marian1911/CUBESAT_Transponder/README.md

Todos los archivos de diseño, simulaciones, componentes y codigo referido a transponder cubesat VHF-UHF
