marian1911/CUBESAT_Transponder/Simulaciones/filter_esquema.pdf

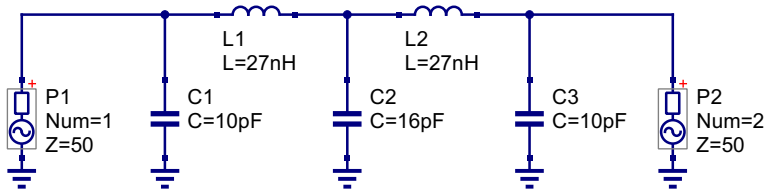
[picture p121: figure]
P1 Num=1 Z=50; P2 Num=2 Z=50

### s-parameter simulation

SP1
Type=log
Start=1MHz Stop=1GHz Points=1000 low-pass filter, 450MHz cutoff 5

th order Chebyshev , PI-type, impedance 50 Ω
