marian1911/CUBESAT_Transponder/Simulaciones/cascode_1.pdf

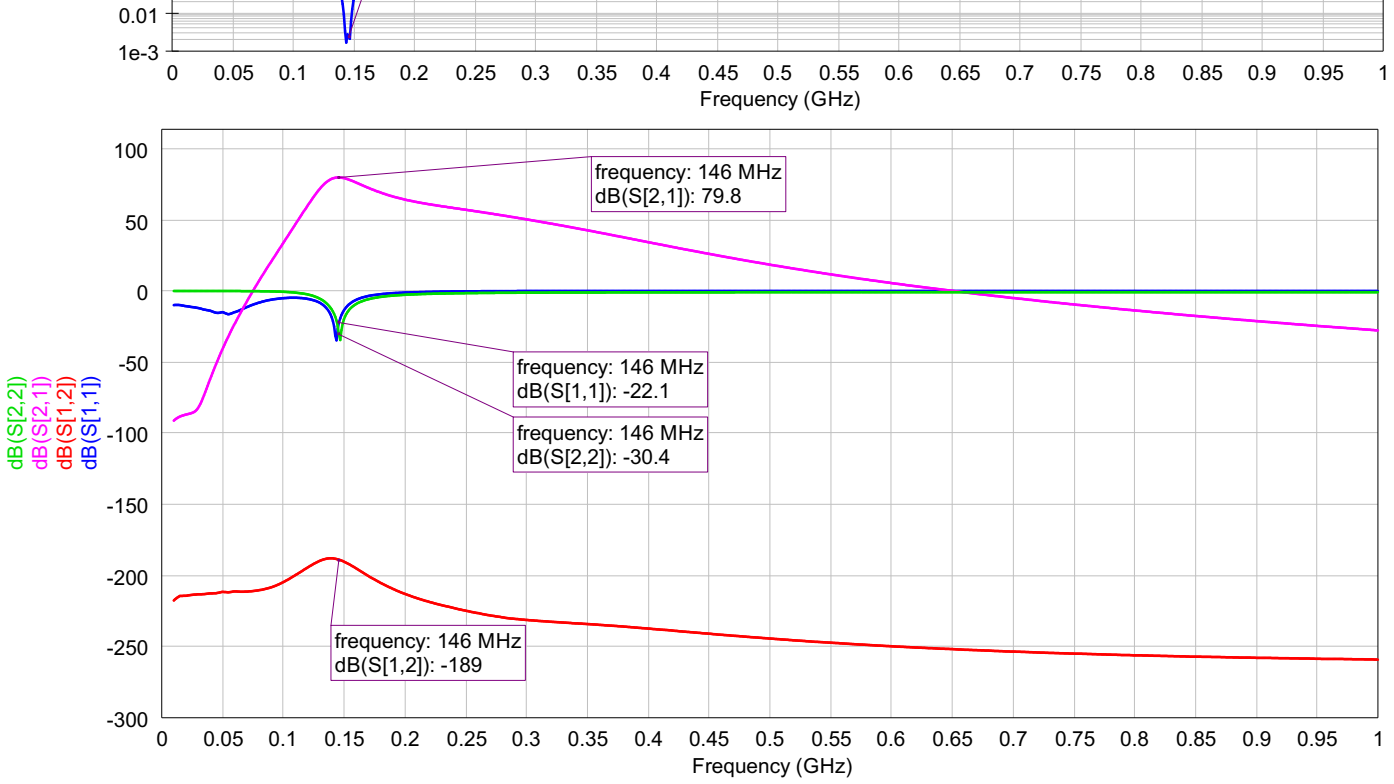
[picture p122: figure]
Frequency (GHz); frequency: 146 MHz dB(S[1,2]): -189; frequency: 146 MHz dB(S[2,1]): 79.8

equation Coeficiente de Rollet

Determinante delta

Eqn1
k=(1 - mag(S[1,1])^2 - mag(S[2,2])^2 + mag(S[1,1]*S[2,2] - S[1,2]*S[2,1])^2) / (2 * mag(S[1,2] * S[2,1])) delta=mag(S[1,1]*S[2,2] - S[1,2]*S[2,1])

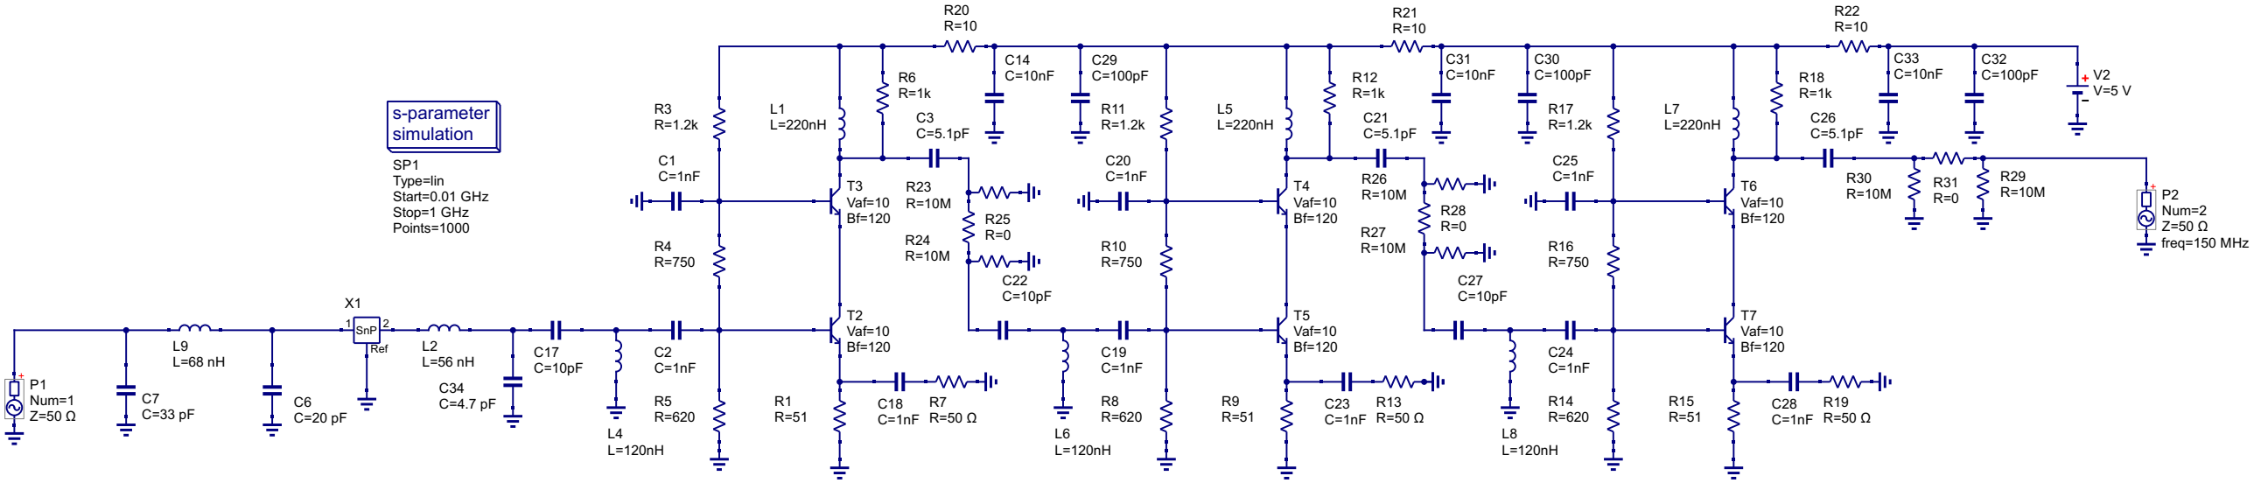
[picture p123: figure]
P2 Num=2 Z=50 Ω; freq=150 MHz R31 R=0; T2 Vaf=10 Bf=120; T3 Vaf=10 Bf=120; T4 Vaf=10 Bf=120; T5 Vaf=10 Bf=120; T6 Vaf=10 Bf=120; T7 Vaf=10 Bf=120; SnP; Ref; P1 Num=1 Z=50 Ω; s-parameter simulation

Type=lin Start=0.01 GHz Stop=1 GHz Points=1000 frequency: 146 MHz dB(S[1,1]): -22.1 frequency: 146 MHz dB(S[1,1]): -22.1

frequency: 146 MHz dB(S[2,2]): -30.4 frequency: 146 MHz dB(S[2,2]): -30.4

0 | 0.1 | 0.2 | 0.3 | 0.4 | 0.5 | 0.6 | 0.7 | 0.8 | 0.9 | 1

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
# dB(S[1,1]) dB(S[2,2])

Frequency (GHz)

0 | 0.2 | 0.4 | 0.6 | 0.8 | 1

-100

-50

0

50

100

dB(S[2,1])

Frequency (GHz)

0 | 0.2 | 0.4 | 0.6 | 0.8 | 1

-260

-250

-240

-230

-220

-210

-200

-190

-180

dB(S[1,2])

Frequency (GHz)

frequency

S[1,1] S[2,2]

frequency: 146 MHz S[1,1]: 0.0781 / -33.6° Z = 56.9 / -4.97°

frequency: 146 MHz S[1,1]: 0.0781 / -33.6° Z = 56.9 / -4.97° frequency: 146 MHz S[2,2]: 0.0301 / -139° Z = 47.8 / -2.27°

frequency: 146 MHz S[2,2]: 0.0301 / -139° Z = 47.8 / -2.27°

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
1e10

1e11

delta

k

frequency: 146 MHz delta: 0.00235

frequency: 146 MHz delta: 0.00235

frequency: 146 MHz
k: 1.41e+05

frequency: 146 MHz

k: 1.41e+05 ========================================= CALCULO DE ADAPTACION DE ENTRADA (146 MHz) ========================================= Objetivo: Adaptar fuente de 50 ohms a la entrada del primer cascode. 1. Parametros Iniciales: - Impedancia medida (S11): 196 / -43.9 grados

- Equivalente rectangular: Zin = 141.2 - j135.9 ohms
- Equivalente paralelo: R_paralelo = 272 ohms, X_paralelo = -283 ohms (Capacitancia parásita)
2. Diseño de Red Tipo L: - Factor de Calidad (Q) = raiz(272 / 50 - 1) = 2.1
3. Componentes Finales: - Inductor Paralelo (Base a Masa): Debe cancelar la reactancia parásita y adaptar. Valor L = 96.5 nH
- Capacitor Serie (Fuente a Base): Bloquea DC y completa adaptación. Xc = 105 ohms. Valor C = 10.4 pF

========================================= CALCULO DE ADAPTACION DE SALIDA (146 MHz) ========================================= Objetivo: Adaptar la salida de alta impedancia a 50 ohms. 1. Parametros Iniciales: - Impedancia interna del transistor: 1570 / -89.9 grados

- Equivalente paralelo: Rp = 900 kOhms, Cp = 0.69 pF
- Resistencia de carga (Load Line) impuesta por diseño: 1000 ohms
2. Diseño de Red Tipo L (Absorbiendo parásitos): - Factor de Calidad (Q) = raiz(1000 / 50 - 1) = 4.36
3. Componentes Finales: - Capacitor Serie (Colector a Carga): Xc = 50 * 4.36 = 218 ohms. Valor C16 = 5.0 pF
- Inductor Paralelo (Colector a VCC): Reactancia ideal = 1000 / 4.36 = 229.4 ohms. Compensando los 0.69 pF internos, la reactancia baja a 200.1 ohms. Valor L3 = 218 nH

=========================================

Atenuador de 3 dB
Resistencias a masa (Shunt): 300 ohmios
Resistencia en serie (Series): 18 ohmios

Atenuador de 6 dB
Resistencias a masa (Shunt): 150 ohmios Resistencia en serie (Series): 39 ohmios

Atenuador de 12 dB
Resistencias a masa (Shunt): 82 ohmios Resistencia en serie (Series): 91 ohmios
