marian1911/CUBESAT_Transponder/Librerias/Infineon/BGB741L7ESDE6327XTSA1/Infineon_LNA_Switch/Readme.txt

*******************************************************************
*
*     INFINEON ADS LIBRARY for MMIC LNA
*
*     Version 3.0
*     Date 01/02/2018
*
*     Copyright (C) 2015 by Infineon Technologies AG, Neubiberg, Germany
*     all rights reserved
*
*
*     This library contains the following MMIC LNAs:
*
*     BGA622L7		BGA7L1N6		BGA7M1N6
*     BGA7H1N6		BGA7L1BN6		BGA7H1BN6
*     BGA6L1BN6		BGA6H1BN6		BGA8L1BN6		      
*     BGA8H1BN6  	BGA8V1BN6		BGA8U1BN6
*     BGA824N6		BGA622L7		BGA777N7   
*     BGA711N7		BGA713N7		BGA751N7     
*     BGA735N16		BGA748L16     		BGA15LA12
*     BGA15MA12     	BGM16HA12		BGM12LAB9
*     BGM13GAB9		BGM13HAB9		BGM15LAB12     
*     BGM17LAB12	BGM7LLHM4L12		BGM7LMHM4L12  
*     BGM7MLLM4L12	BGM7MHLL4L12		BGA728L7
*     BGA729N6		BGB741L7ESD		BGB707L7ESD  
*     BGB719N7ESD  	BGA524N6		BGA924N6
*     BGA231N7		BGA428			BGA615L7                   
*     BGA925L6		BGA725L6                  
*                       
*                       
*
*
*******************************************************************

Please note that the Infineon Component Library has the same folder names, independent on the library version.
Therefore your current Infineon libraries may be overwritten when installing a newer one. Please rename your
current ADS library folder for your own records or contact the Infineon Customer Support
for older versions of your library. If using the new library with an older design make
sure to add the new library to your workspace.
