marian1911/CUBESAT_Transponder/Para análisis/Links.txt

https://haciaelespacio.aem.gob.mx/revistadigital/articul.php?interior=1128

https://alen.space/es/guia-basica-de-nanosatelites/
