marian1911/CUBESAT_Transponder/Invoice_jlcpcb.pdf

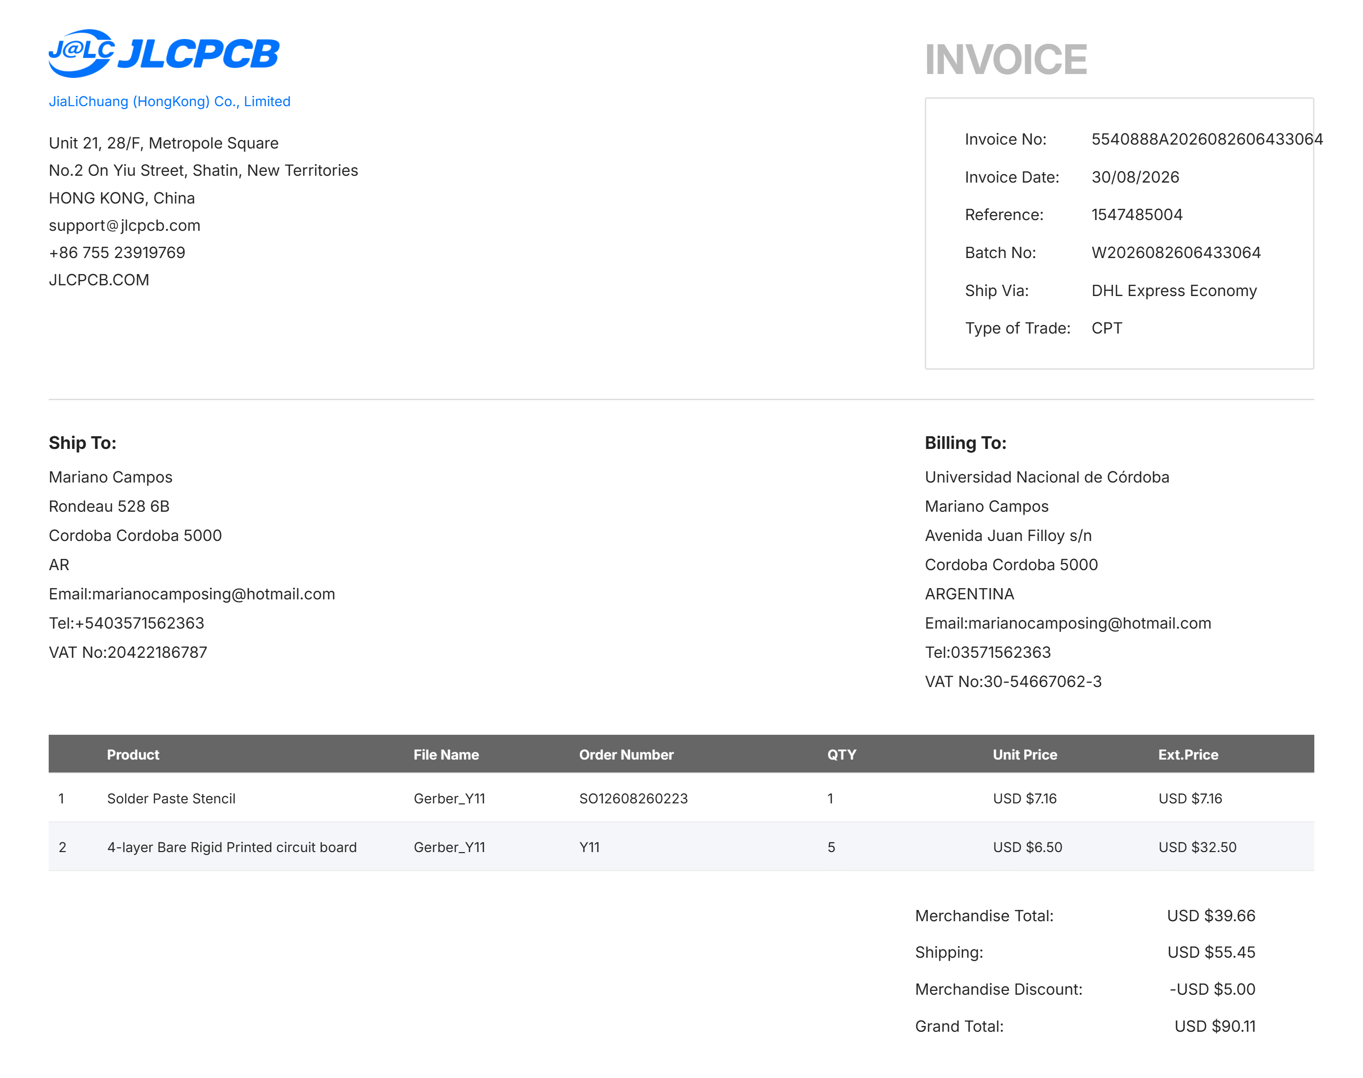
[picture p148: figure]
