marian1911/CUBESAT_Transponder/Factura_JLCPCB.pdf

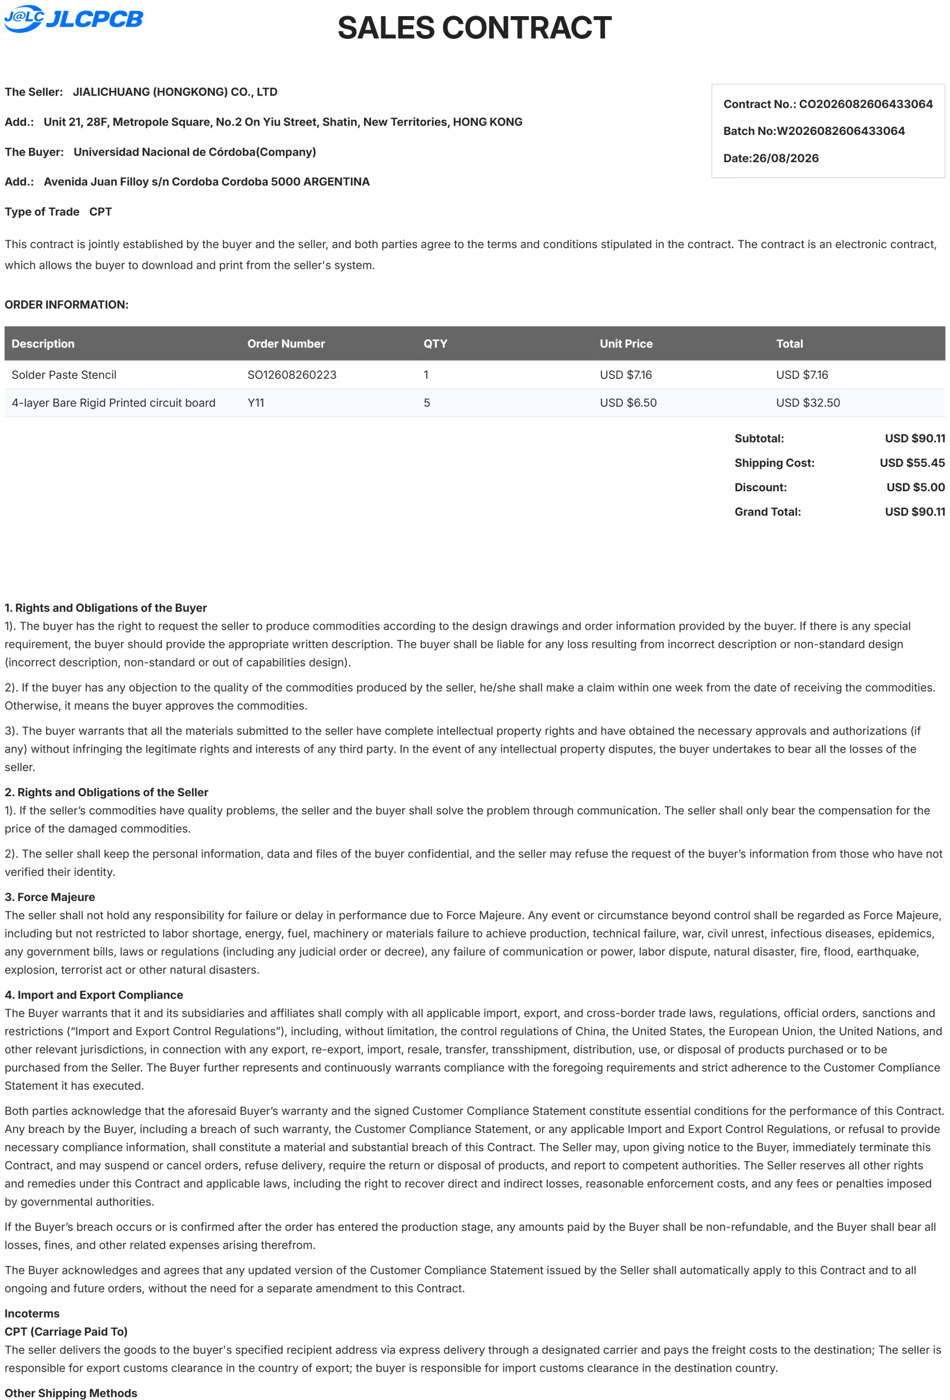
[picture p149: page 1]

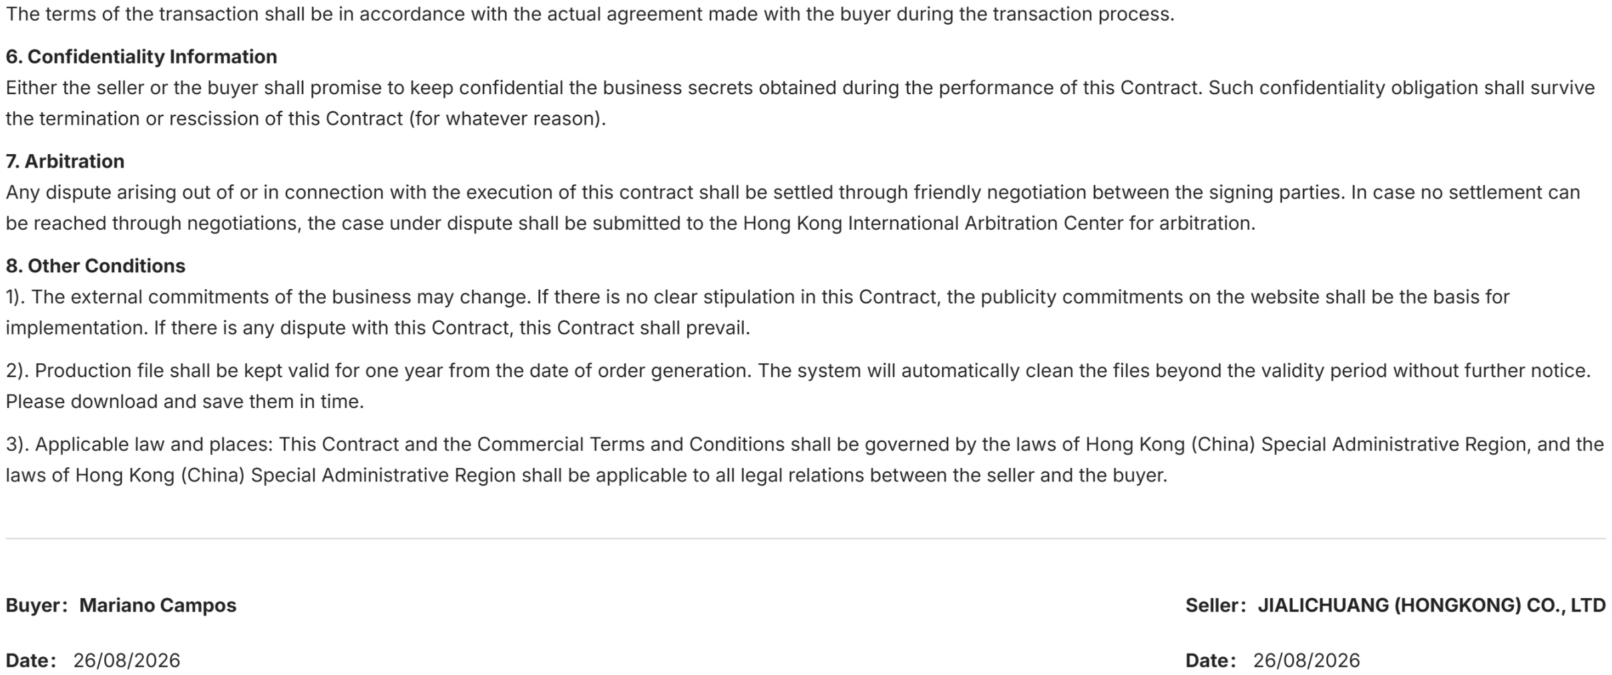
[picture p150: figure]
