marian1911/CUBESAT_Transponder/Simulaciones/lna.pdf

L1L=68 nH | SnPRef 1 | 2 X1 | L2L=56 nH | C5 C=4.7 pF C7 C=33 pF | C6 C=20 pF P1Num=1 Z=50 Ω | P2Num=2 Z=50 Ω s-parameter simulation SP1 Type=lin Start=0.01 GHz Stop=1 GHz Points=991 | 0 | 0.1 | 0.2 | 0.3 | 0.4 | 0.5 | 0.6 | 0.7 | 0.8 | 0.9 | 1 -100 -80 -60 -40 -2002040 dB⁽S[1,1]) dB⁽S[1,2]) dB⁽S[2,1]) dB⁽S[2,2]) | Frequency (GHz) frequency: 146 MHz dB(S[1,1]): -28 frequency: 146 MHz dB(S[1,1]): -28frequency: 146 MHz dB(S[1,2]): -28.1 frequency: 146 MHz dB(S[1,2]): -28.1 frequency: 146 MHz dB(S[2,1]): 23.9 frequency: 146 MHz dB(S[2,1]): 23.9 frequency: 146 MHz dB(S[2,2]): -32.1 frequency: 146 MHz dB(S[2,2]): -32.1 | 0 | 0.1 | 0.2 | 0.3 | 0.4 | 0.5 | 0.6 | 0.7 | 0.8 | 0.9 | 1 050 100 150 200 250 300 350 stoz⁽S[1,1]) stoz⁽S[2,2]) | Frequency (GHz) frequency: 146 MHz stoz(S[1,1]): 53.8 / -1.74° frequency: 146 MHz stoz(S[1,1]): 53.8 / -1.74° frequency: 146 MHz stoz(S[2,2]): 49.5 / 2.81° frequency: 146 MHz stoz(S[2,2]): 49.5 / 2.81°
