marian1911/CUBESAT_Transponder/PI/Informe/imagenes/cascode_3.png

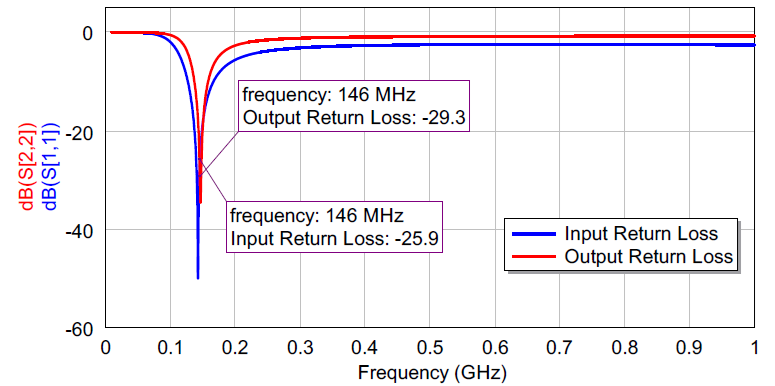
PI/Informe/imagenes/cascode_3.png
