marian1911/CUBESAT_Transponder/PI/Informe/imagenes/sat1.jpeg

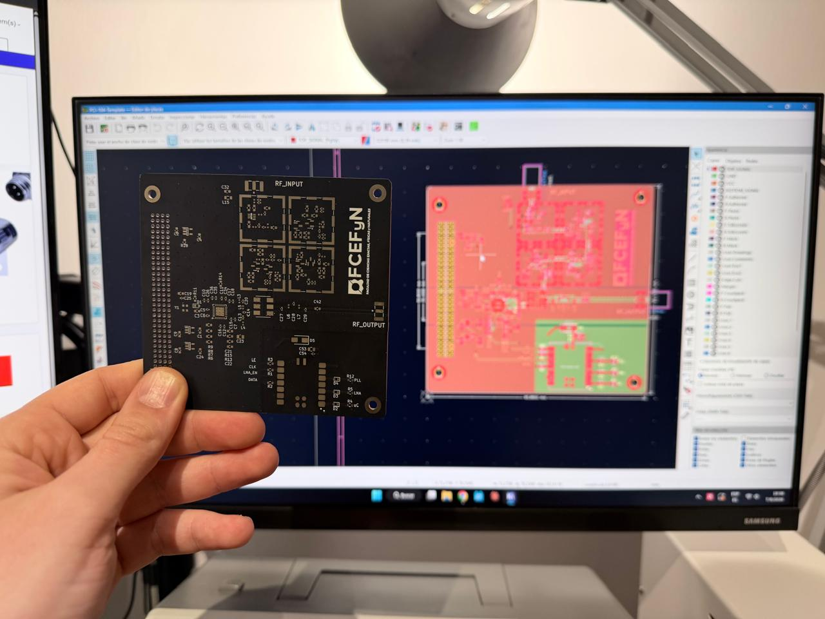
PI/Informe/imagenes/sat1.jpeg
