marian1911/CUBESAT_Transponder/PI/Informe/imagenes/sat2.jpeg

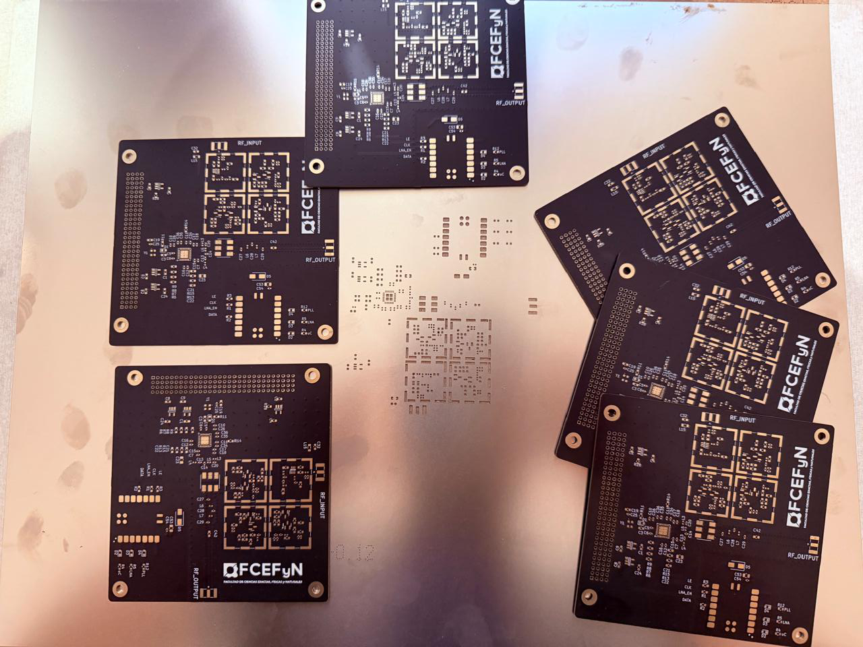
PI/Informe/imagenes/sat2.jpeg
