marian1911/CUBESAT_Transponder/PI/Informe/imagenes/sat3.jpeg

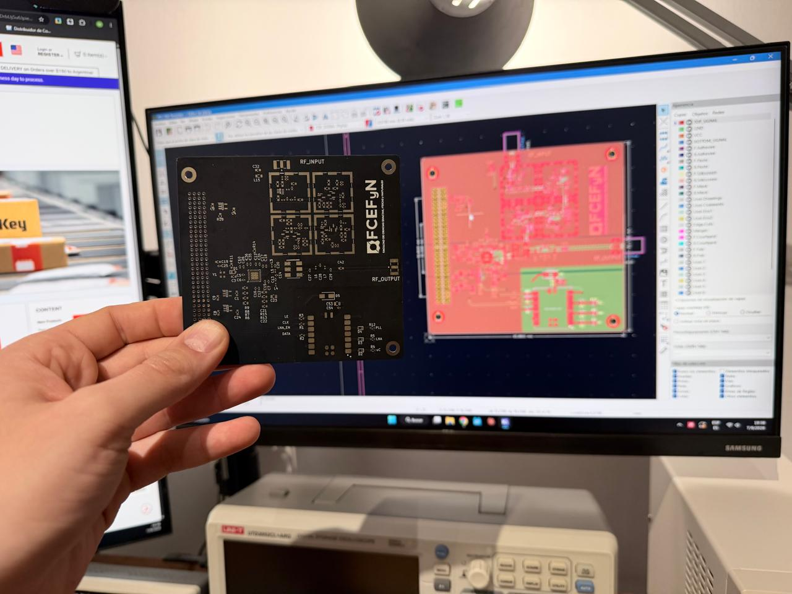
PI/Informe/imagenes/sat3.jpeg
