marian1911/CUBESAT_Transponder/PI/Informe/imagenes/stencil.jpeg

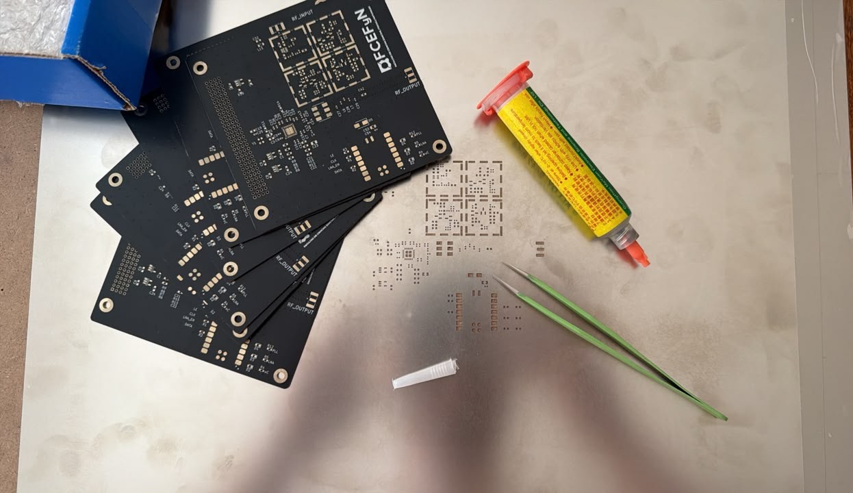
PI/Informe/imagenes/stencil.jpeg
