marian1911/CUBESAT_Transponder/PI/Presentacion/Imagenes/contenteetimes-images-00-max-embedded-2017-01-jan-rob-0001-emb-cst-01.webp

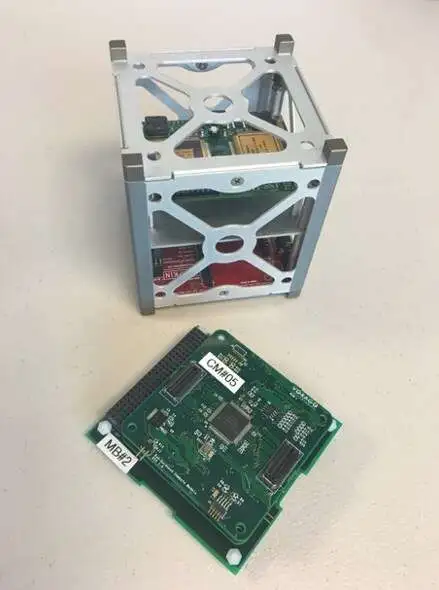
PI/Presentacion/Imagenes/contenteetimes-images-00-max-embedded-2017-01-jan-rob-0001-emb-cst-01.webp
