marian1911/CUBESAT_Transponder/PI/Presentacion/Imagenes/CubeSats_solar_panel_standard_DHV.webp

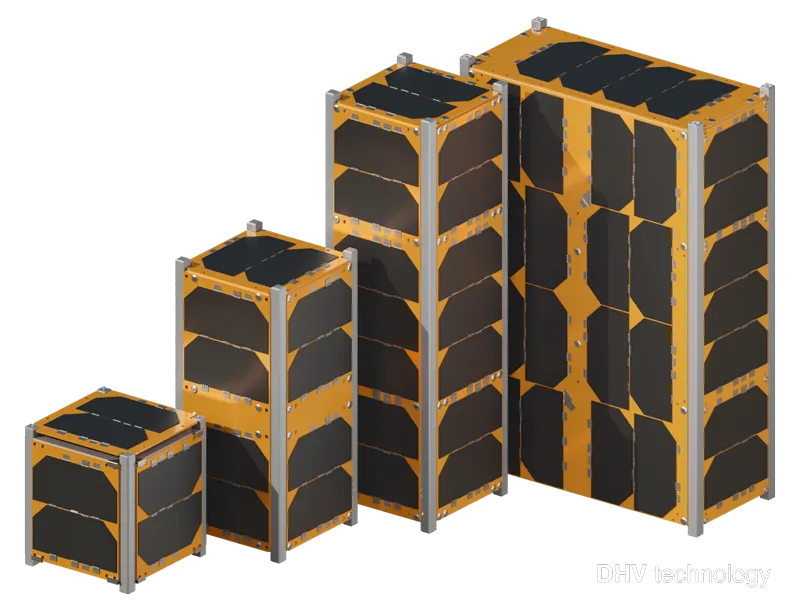
PI/Presentacion/Imagenes/CubeSats_solar_panel_standard_DHV.webp
