marian1911/CUBESAT_Transponder/PI/Presentacion/Imagenes/images (1).jpg

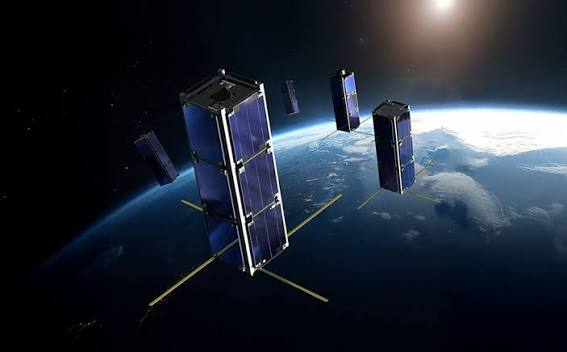
PI/Presentacion/Imagenes/images (1).jpg
