marian1911/CUBESAT_Transponder/PI/Presentacion/Imagenes/images.jpg

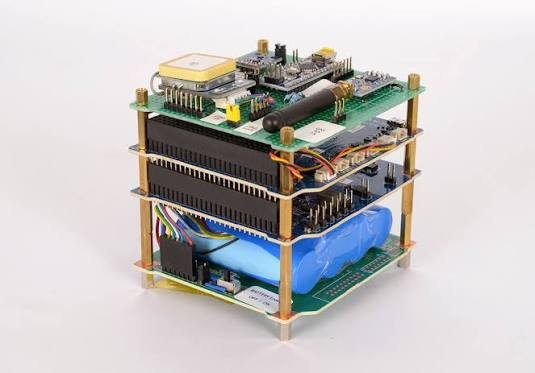
PI/Presentacion/Imagenes/images.jpg
