marian1911/CUBESAT_Transponder/PI/Presentacion/Imagenes/ITUpSat1_Auto2.jpg

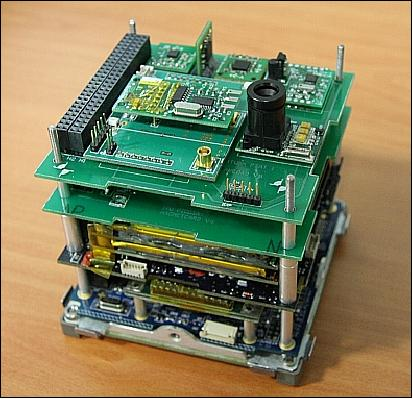
PI/Presentacion/Imagenes/ITUpSat1_Auto2.jpg
