marian1911/CUBESAT_Transponder/PI/Presentacion/Imagenes/payload.png

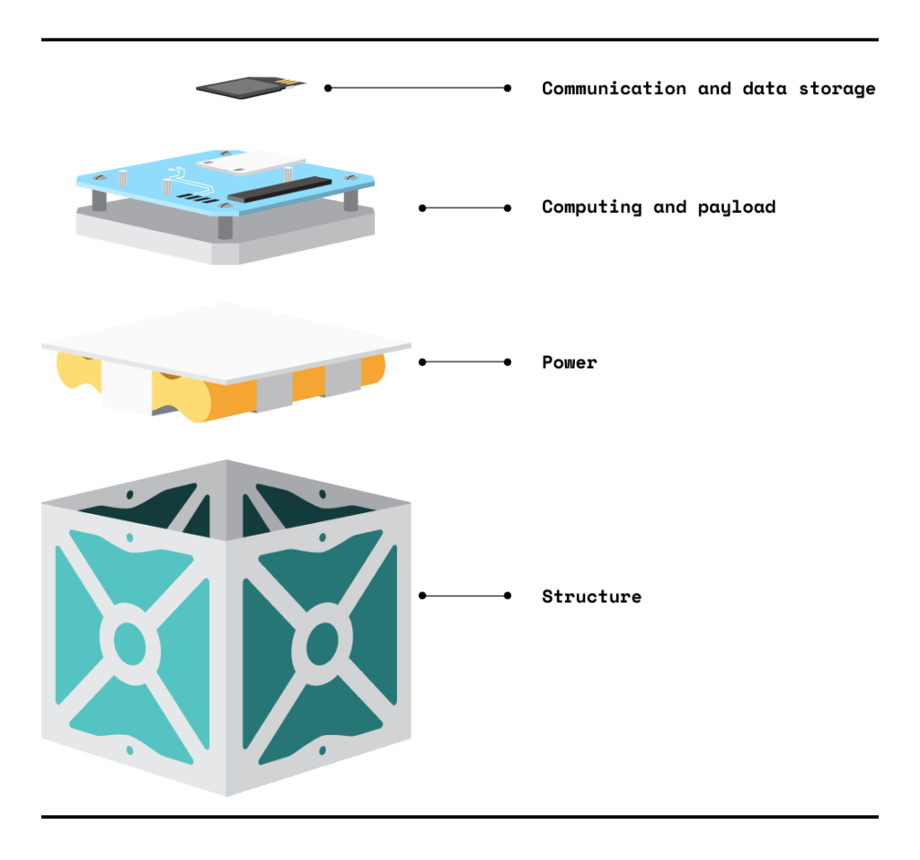
PI/Presentacion/Imagenes/payload.png
