marian1911/CUBESAT_Transponder/PI/Presentacion/Imagenes/satsearch_0qvm50_innovative_solutions_in_space_vhf_uplink_uhf_downlink.png

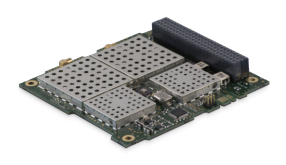
PI/Presentacion/Imagenes/satsearch_0qvm50_innovative_solutions_in_space_vhf_uplink_uhf_downlink.png
