marian1911/CUBESAT_Transponder/PI/Presentacion/Imagenes/satsearch_product-image_mcdilp_data_patterns_cubesat_vhf_uhf_transceiver.png

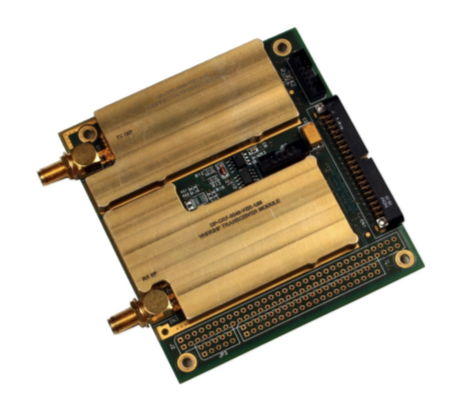
PI/Presentacion/Imagenes/satsearch_product-image_mcdilp_data_patterns_cubesat_vhf_uhf_transceiver.png
