marian1911/CUBESAT_Transponder/KICAD_CUBSAT_V1/BOM.csv

Qty | Manufacturer_Part_Number | Mouser Part Number
1 | ADP150AUJZ-3.3-R7 | 584-ADP150AUJZ3.3R7
3 | TNPW02011K20BEED | 71-TNPW02011K20BEED
3 | CRCW0201620RFKED | 71-CRCW0201620RFKED
3 | CRCW01000000Z0EL | 71-CRCW01000000Z0EL
1 | 102010328 | 713-102010328
2 | GJM1555C1H5R6WB01D | 81-GJM1555C1H5R6WB1D
2 | GCM1885C1H181JA16D | 81-GCM1885C1H181J16D
1 | GRM1555C1H121JA01D | 81-GRM1555C1H121JA01
1 | GCM1885C1H112JA16D | 81-GCM1885C1H112JA6D
1 | GCM21B5C2A333GE02L | 81-GCM21B5C2A333GE2L
1 | MCT0603MD7501BP500 | 594-MCT0603MD7501BP5
1 | RC0603FR-07464RL | 603-RC0603FR-07464RL
1 | RC0603FR-072K94L | 603-RC0603FR-072K94L
1 | LQW15AN68NG0ZD | 81-LQW15AN68NG0ZD
1 | LQW15AWR18J80D | 81-LQW15AWR18J80D
10 | TNPW060349R9FEEA | 71-TNPW060349R9FEEA
2 | SMA-J-P-H-ST-EM1 | 200-SMAJPHSTEM1
1 | ADE-5+ | 139-ADE-5
1 | LQW15AN56NG8ZD | 81-LQW15AN56NG8ZD
3 | LQW18ANR22G00D | 81-LQW18ANR22G00D
1 | PSA-5454+ | 139-PSA-5454
2 | LQW15AN30NG00D | 81-LQW15AN30NG00D
2 | LQW15AN27NG00D | 81-LQW15AN27NG00D
4 | LQW15AWR12G80D | 81-LQW15AWR12G80D
2 | CRCW040282R0FKTD | 71-CRCW040282R0FKTD
1 | CRCW040291R0FKED | 71-CRCW040291R0FKED
1 | CRCW040239R0FKED | 71-CRCW040239R0FKED
2 | CRCW0402150RFKED | 71-CRCW0402-150-E3
3 | MCT06030D7500BP500 | 594-MCT06030D7500BP5
2 | MCT06030C1009FP500 | 594-MCT06030C1009FP5
1 | ECS-TXO-2520MV-100-AY-TR | 520-TXO2520MV100AYTR
3 | GJM0225C1C5R1BB01L | 81-GJM0225C1C5R1BB1L
4 | BMI-S-102 | 739-BMI-S-102
4 |  | 859-LTST-C190GKT
1 | LQW21FT1R0M0HL | 81-LQW21FT1R0M0HL
1 | GRT21BR61E106KE13L | 81-GRT21BR61E106KE3L
1 | GJM0225C1E4R7BB01L | 81-GJM0225C1E4R7BB1L
1 | GCM1555C1H330FA16J | 81-GCM1555C1H330FA6J
1 | GJM1555C1H200FB01D | 81-GJM1555C1H200FB1D
4 | GRM188R61E225KA12D | 81-GRM188R61E225KA2D
3 | GCM1555C1H101FA16J | 81-GCM1555C1H101FA6J
3 | GRM188R61A105KA61D | 81-GRM39R105K10
1 | TNPW06035K10FHTA | 71-TNPW06035K10FHTA
1 | SS14 | 512-SS14
1 | ADF4351BCPZ-RL7 | 584-ADF4351BCPZ-R7
2 | ADP7118WAUJZ-5.0-R7 | 584-P7118WAUJZ-50-R
7 | TNPW06031K00FHEA | 71-TNPW06031K00FHEA
12 | GRM1885C1H102JA01D | 81-GRM39C102J50
1 | GRM1555C1H100JA01D | 81-GRM1555C1H100JA1D
5 | TNPW060310K0FEEA | 71-TNPW060310K0FEEA
11 | GRM155R71C104KA88D | 81-GRM155R71C104KA88
1 | GJM1555C1H160FB01J | 81-GJM1555C1H160FB1J
1 | GRM1885C1H152JA01J | 81-GRM185C1H152JA01J
11 | GJM1555C1H100FB01D | 81-GJM1555C1H100FB01
