marian1911/CUBESAT_Transponder/Librerias/Crystek/CVCO55BE-0400-0800/3D/CVCO55BE-0400-0800.stp

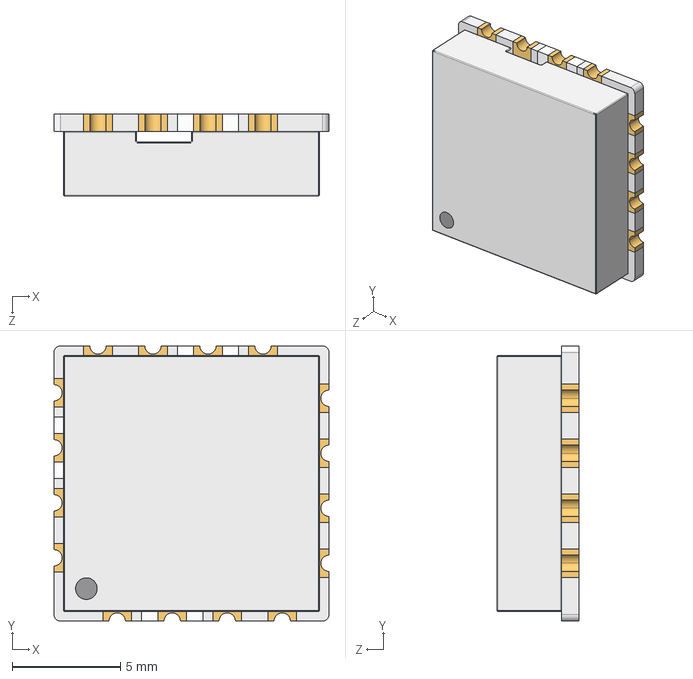
[picture p164: CAD file, 2026-08-06]
Librerias/Crystek/CVCO55BE-0400-0800/3D/CVCO55BE-0400-0800.stp
12.7 x 12.7 x 3.81 mm
