marian1911/CUBESAT_Transponder/Librerias/Laird/bmi-s-102-stp-file.STP

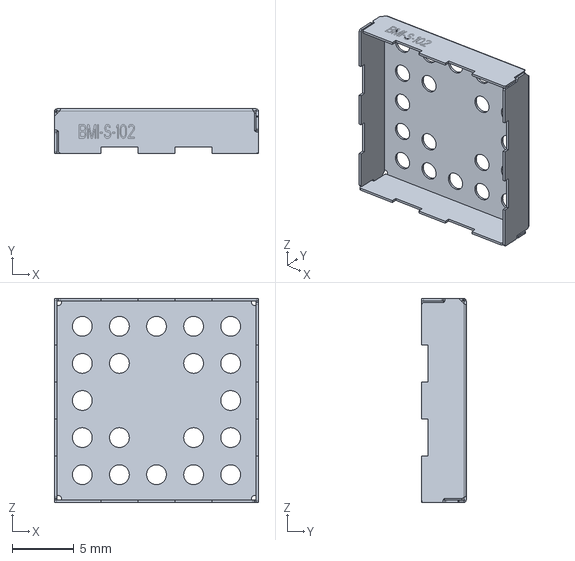
[picture p165: CAD file, 2026-08-06]
Librerias/Laird/bmi-s-102-stp-file.STP
16.5 x 3.60 x 16.5 mm
