marian1911/CUBESAT_Transponder/Librerias/EPCOS/LIB_B39431B3710U410/B39431B3710U410/3D/B39431B3710U410.stp

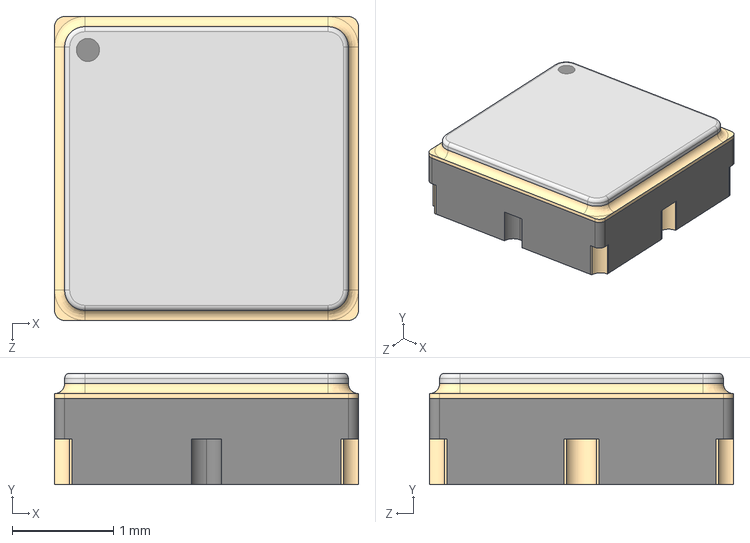
[picture p166: CAD file, 2026-08-06]
Librerias/EPCOS/LIB_B39431B3710U410/B39431B3710U410/3D/B39431B3710U410.stp
3.00 x 1.10 x 3.00 mm
