marian1911/CUBESAT_Transponder/(list of files, cad)

Other CAD files:
Librerias/Crystek/CVCO55BE-0400-0800/DEHDL/cvco55be_0400_0800/chips/chips.prt
Librerias/ECS/ECS-TXO-2520MV-120-AY-TR/DEHDL/ecs_txo_2520mv_120_ay_tr/chips/chips.prt
Librerias/EPCOS/LIB_B39431B3710U410/B39431B3710U410/DEHDL/b39431b3710u410/chips/chips.prt
Librerias/Infineon/BGB741L7ESDE6327XTSA1/BGB_741L7ESD_E6327/DEHDL/bgb_741l7esd_e6327/chips/chips.prt
Librerias/ST/STM32L422CBT6/DEHDL/stm32l422cbt6/chips/chips.prt
Librerias/Torex/XC6206P302MR-G/DEHDL/xc6206p302mr_g/chips/chips.prt
Librerias/analog-device/ADF4117/ADF4117BRUZ-RL7/DEHDL/adf4117bruz_rl7/chips/chips.prt
Librerias/analog-device/ADF4351BCPZ/ADF4350BCPZ-RL7/DEHDL/adf4350bcpz_rl7/chips/chips.prt
Librerias/analog-device/ADP150/ADP150AUJZ-2.65-R7/DEHDL/adp150aujz_2.65_r7/chips/chips.prt
Librerias/mini-circuit/ADE-5+/ADE-5+/DEHDL/ade_5_/chips/chips.prt
Librerias/mini-circuit/PGA-103/PGA-103+/DEHDL/pga_103_/chips/chips.prt
Librerias/mini-circuit/PSA2-6+/PSA2-6+/DEHDL/psa2_6_/chips/chips.prt
Librerias/mini-circuit/TCCH-80+/LIB_TCCH-80+/TCCH-80+/DEHDL/tcch_80_/chips/chips.prt
