marian1911/CUBESAT_Transponder/Simulaciones/pdn_z_graficos.pdf

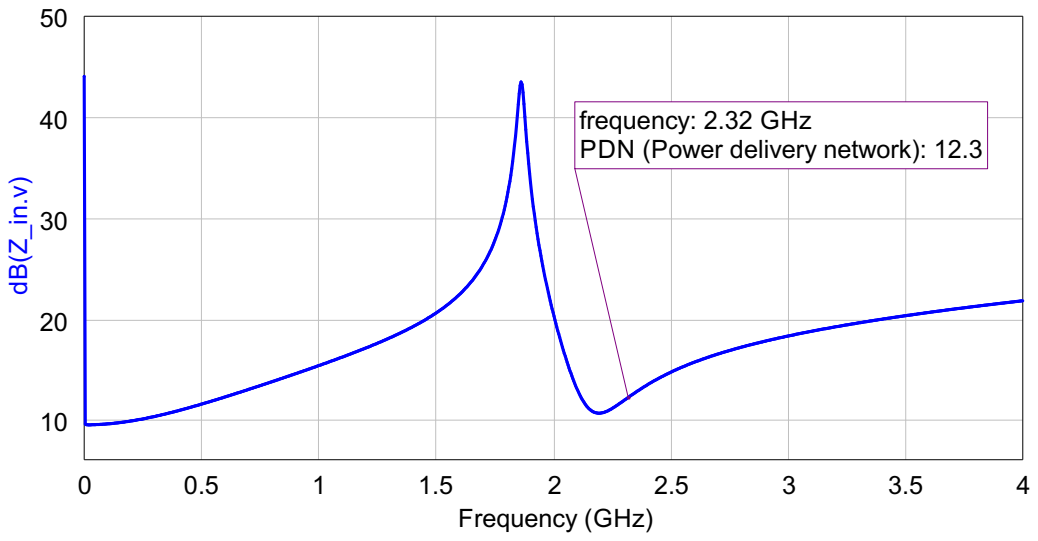
[picture p167: page 1]
Frequency (GHz)

frequency: 2.32 GHz PDN (Power delivery network): 12.3
