marian1911/CUBESAT_Transponder/Simulaciones/filter.pdf

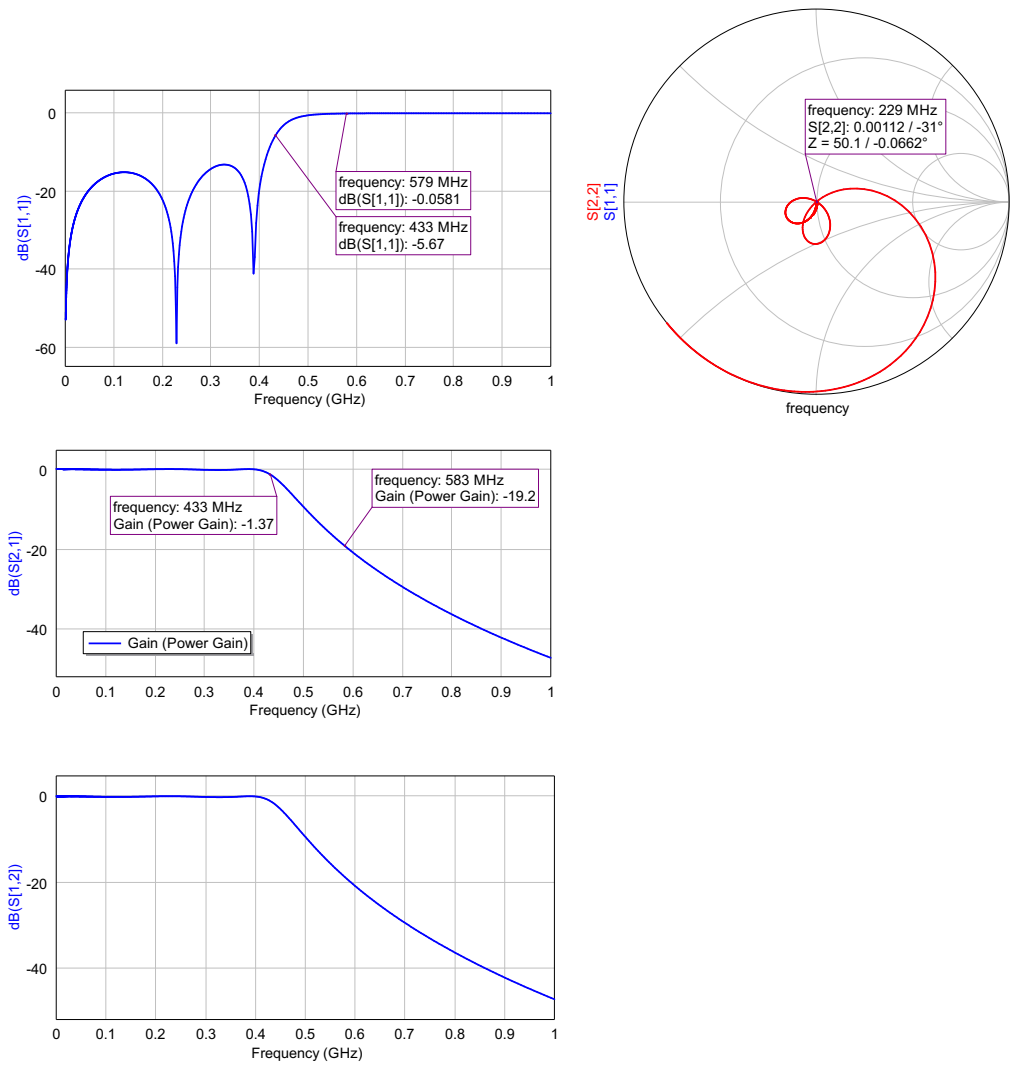
[picture p168: page 1]
frequency; frequency: 229 MHz S[2,2]: 0.00112 / -31° Z = 50.1 / -0.0662°; Frequency (GHz)

frequency: 579 MHz dB(S[1,1]): -0.0581

frequency: 433 MHz dB(S[1,1]): -5.67

frequency: 583 MHz Gain (Power Gain): -19.2

frequency: 433 MHz Gain (Power Gain): -1.37

Gain (PGoawiner(PGoawine)r Gain)
