marian1911/CUBESAT_Transponder/Simulaciones/car_lna.pdf

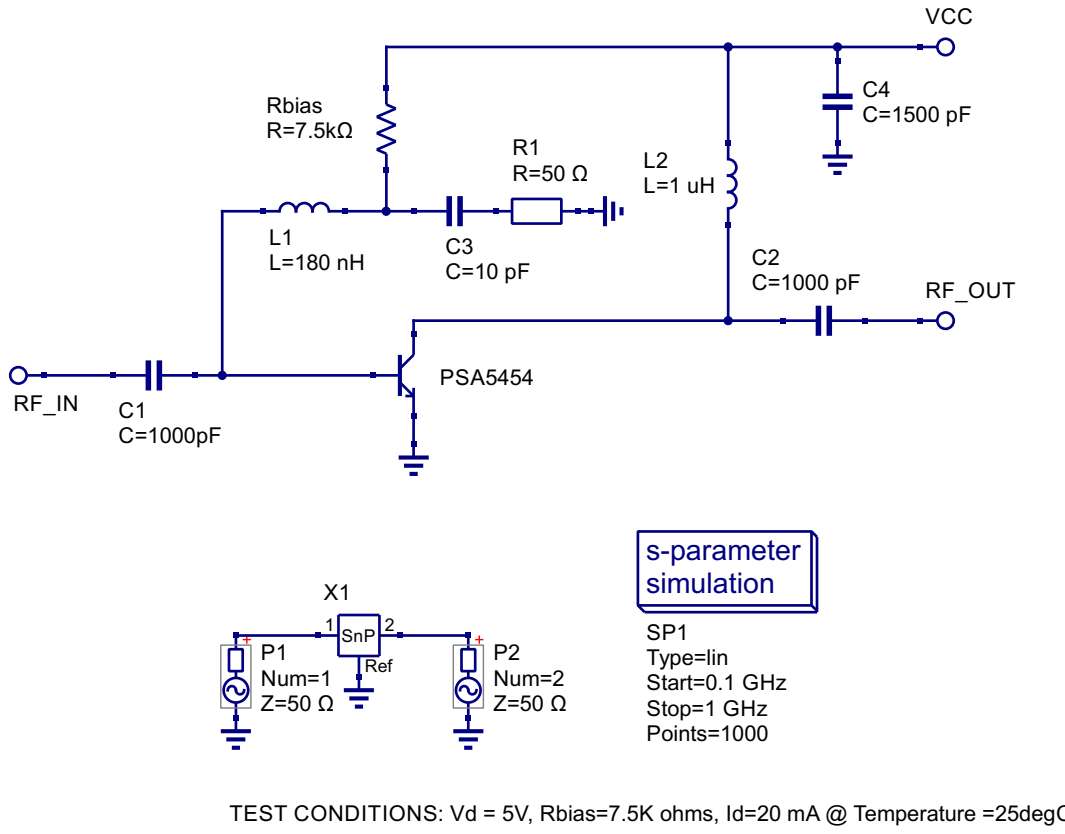
[picture p169: page 1]

Type=lin Start=0.1 GHz Stop=1 GHz Points=1000

TEST CONDITIONS: Vd = 5V, Rbias=7.5K ohms, Id=20 mA @ Temperature =25degC
