marian1911/CUBESAT_Transponder/KICAD_CUBSAT_V1/PCI-104-Template.pdf

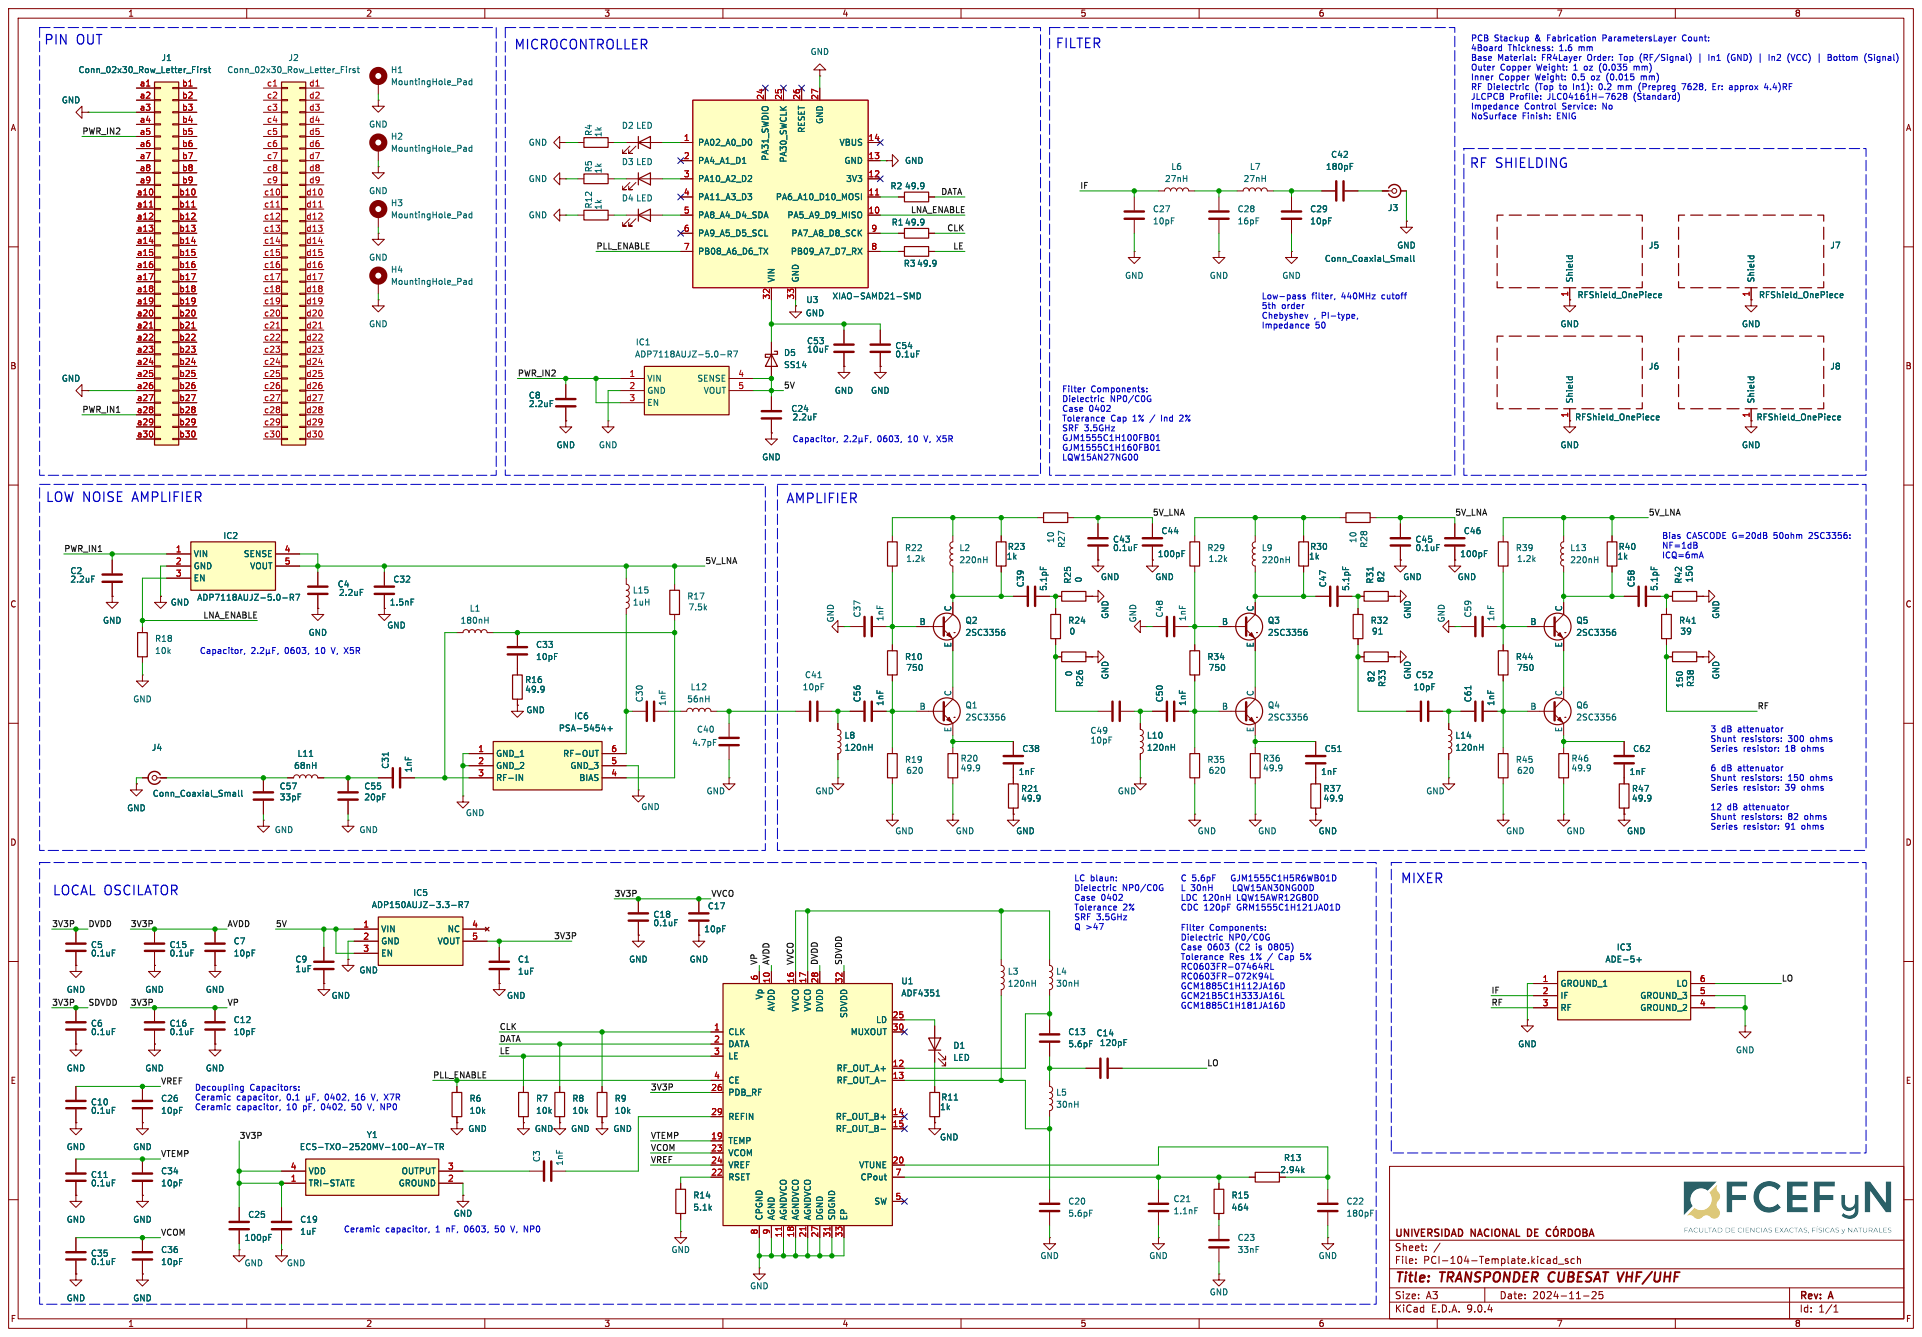
[picture p170: page 1]

1 GND GND GND GND

Case 0402 Tolerance Cap 1% / Ind 2%

Case 0603 (C2 is 0805) Tolerance Res 1% / Cap 5%

9 AGNDVCO 11 VVCO 16 AGNDVCO 18 VVCO 17 AGNDVCO 21 DVDD 28 DGND 27 SDGND 31 SDVDD 32 EP 33

Id: 1/1 Title: TRANSPONDER CUBESAT VHF/UHF
