marian1911/CUBESAT_Transponder/Simulaciones/pdn_tim.pdf

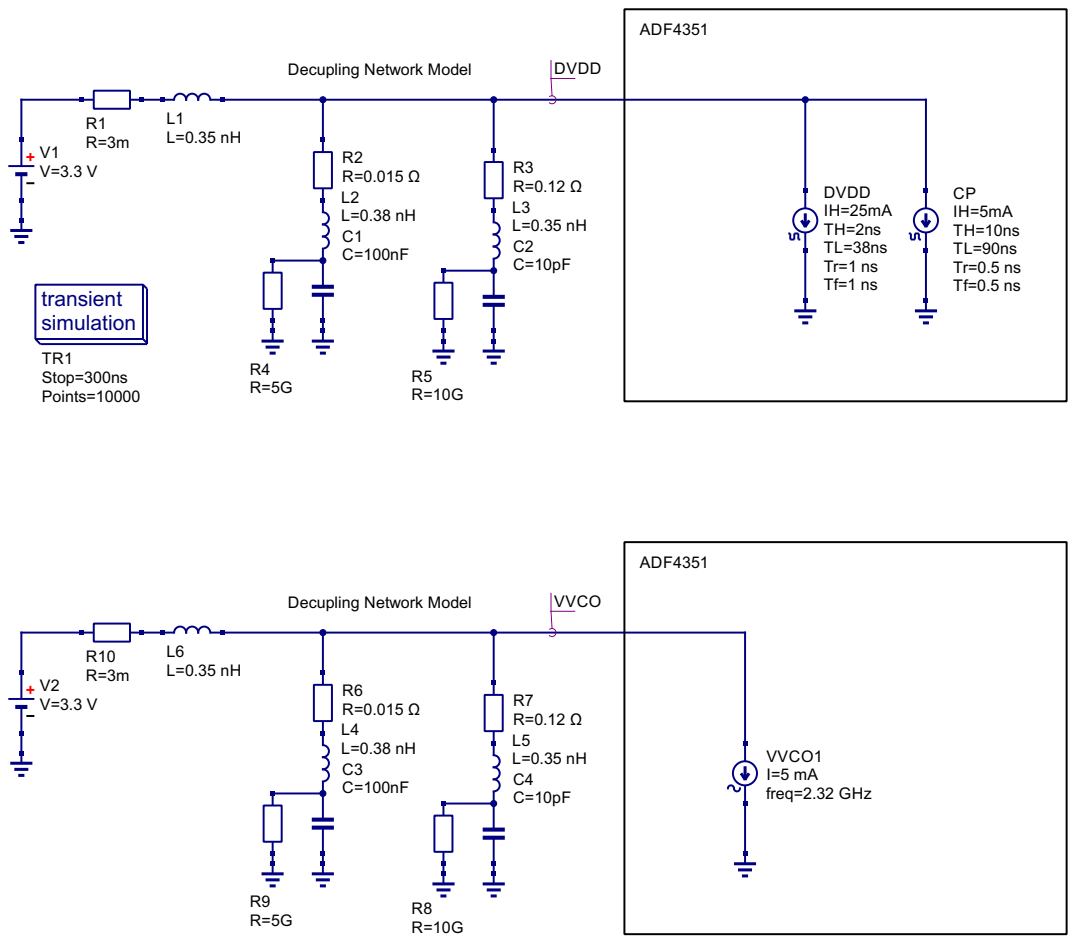
[picture p171: page 1]
