marian1911/CUBESAT_Transponder/Simulaciones/pdn_tim_graficos.pdf

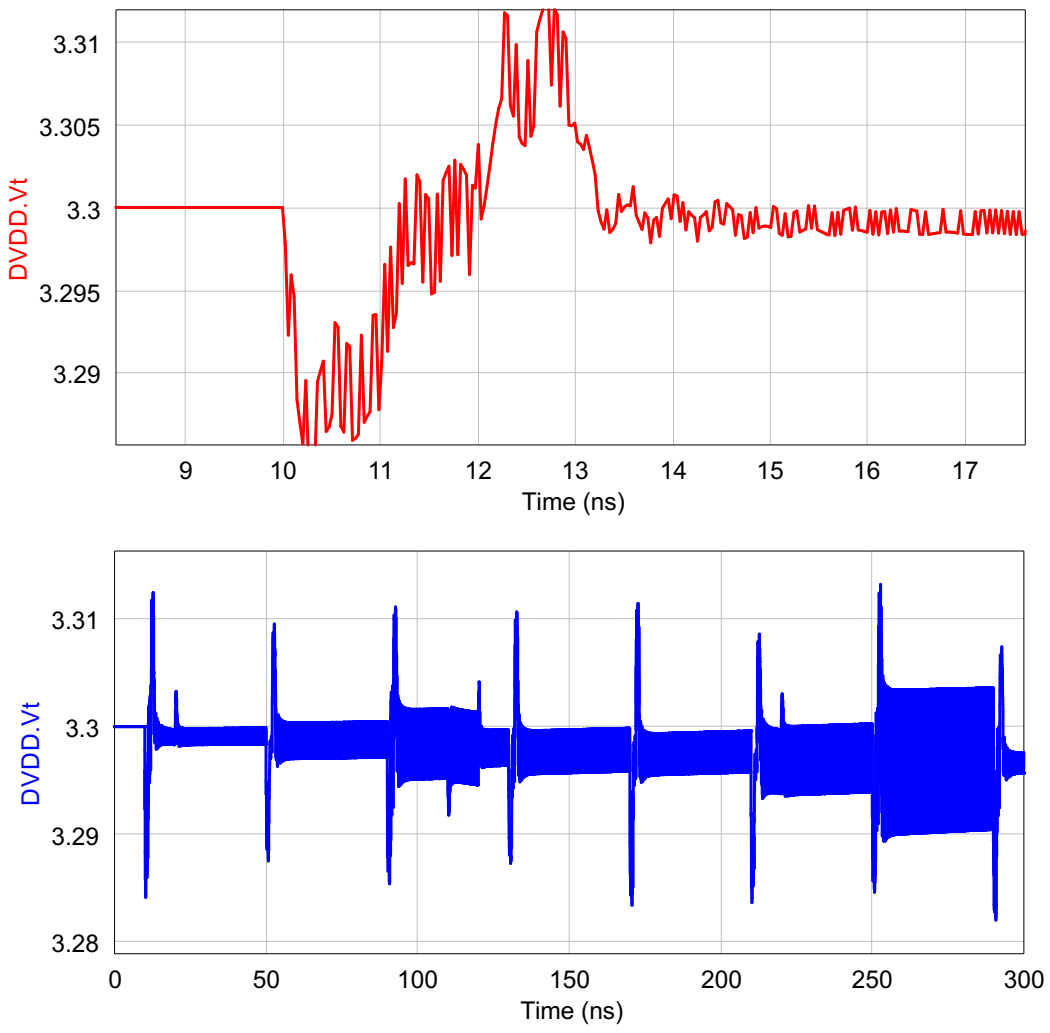
[picture p172: page 1]
Time (ns)
