marian1911/CUBESAT_Transponder/Simulaciones/pdn_z.pdf

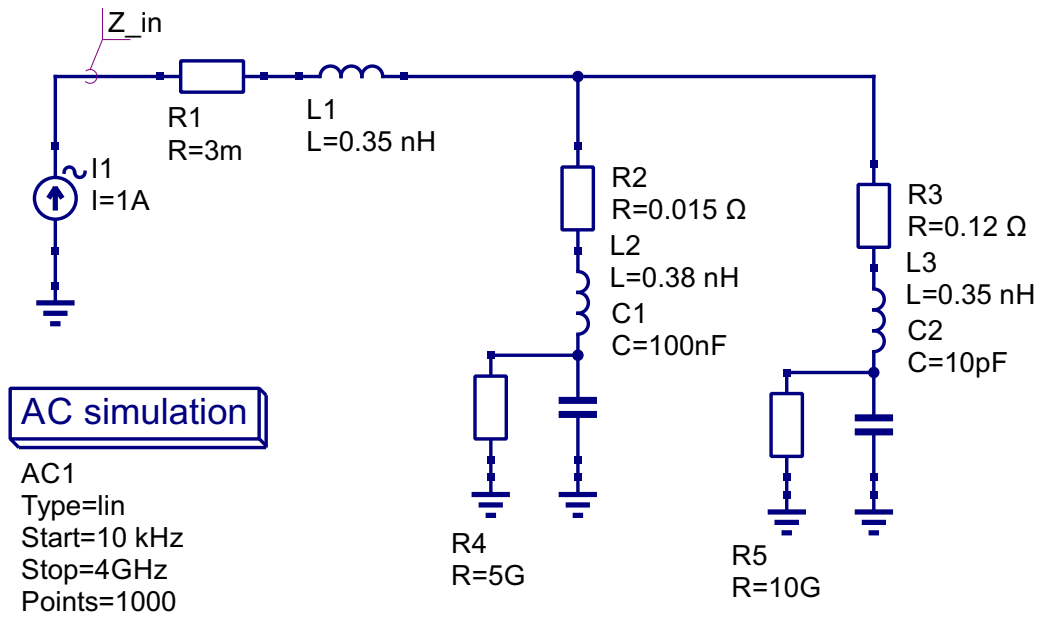
[picture p173: page 1]
R5 R=10G R4 R=5G R1 R=3m AC simulation AC1 Type=lin Start=10 kHz Stop=4GHz Points=1000 Z_in
