marian1911/CUBESAT_Transponder/Simulaciones/cascode_1_graficos.pdf

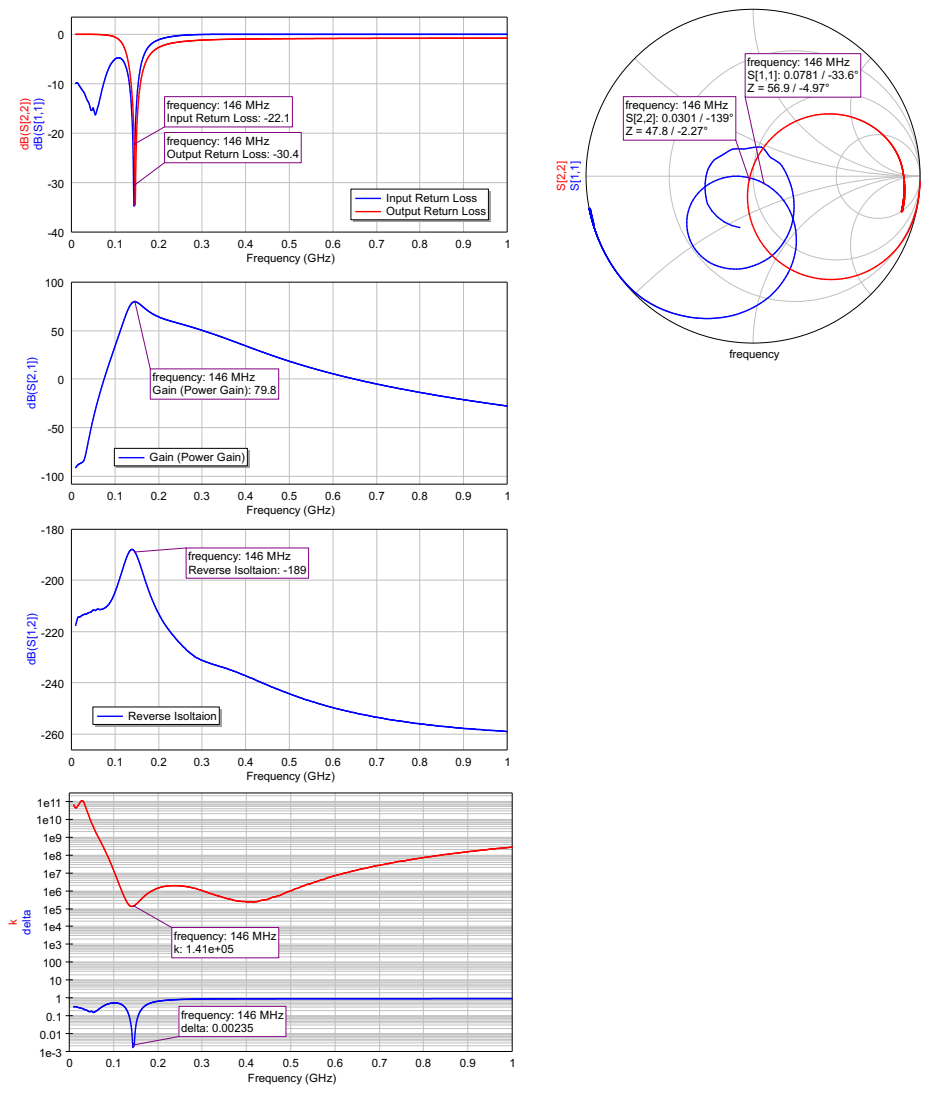
[picture p174: page 1]
Frequency (GHz); ReversReeIsvoelrtsaeioInsoltaion; Output; Return Loss; delta; frequency; frequency: 146 MHz S[1,1]: 0.0781 / -33.6° Z = 56.9 / -4.97°; frequency: 146 MHz S[2,2]: 0.0301 / -139° Z = 47.8 / -2.27°

frequency: 146 frequency: 146 Input Return Loss: -22.1 Input Return Loss: -22.1 | | MHz

frequency: 146 | Return Loss: -30.4 | MHz Output

Input Output Return Loss | Return Loss

Input Return Loss

frequency: 146 MHz Gain (Power Gain): 79.8

Gain (PGoawiner(PGoawine)r Gain)

frequency: 146 MHz Reverse Isoltaion: -189

frequency: 146 MHz
k: 1.41e+05

frequency: 146 MHz delta: 0.00235
