marian1911/CUBESAT_Transponder/Simulaciones/car_cascode_adaptado.pdf

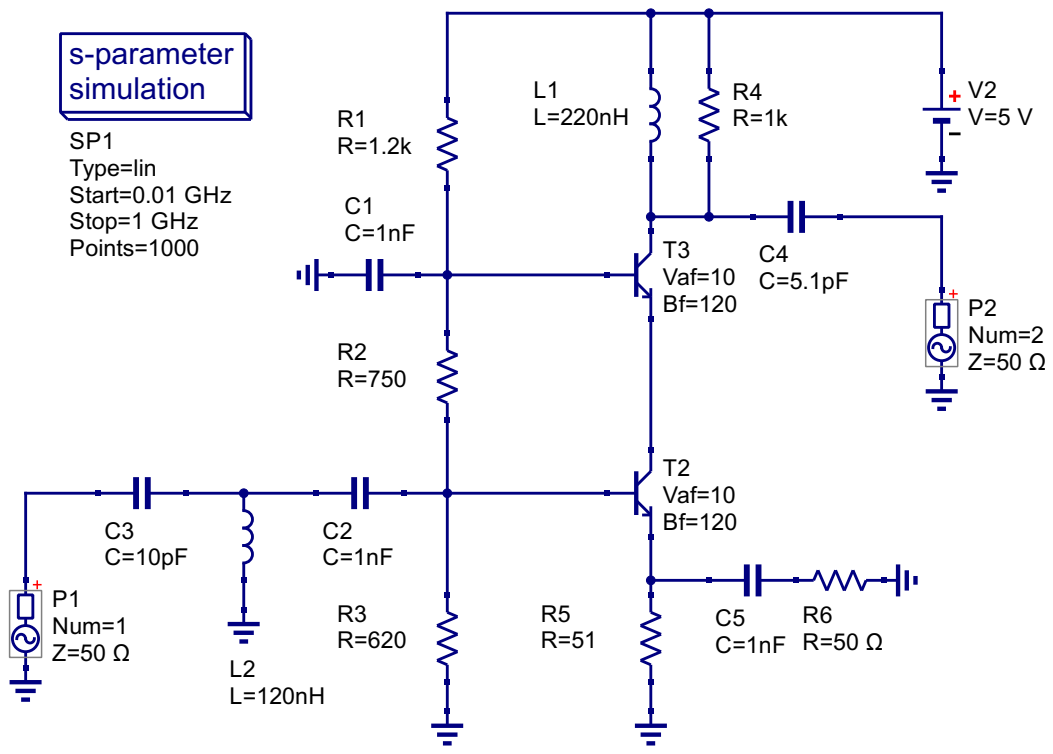
[picture p175: page 1]
