marian1911/CUBESAT_Transponder/Simulaciones/car_cascode_desadaptado.pdf

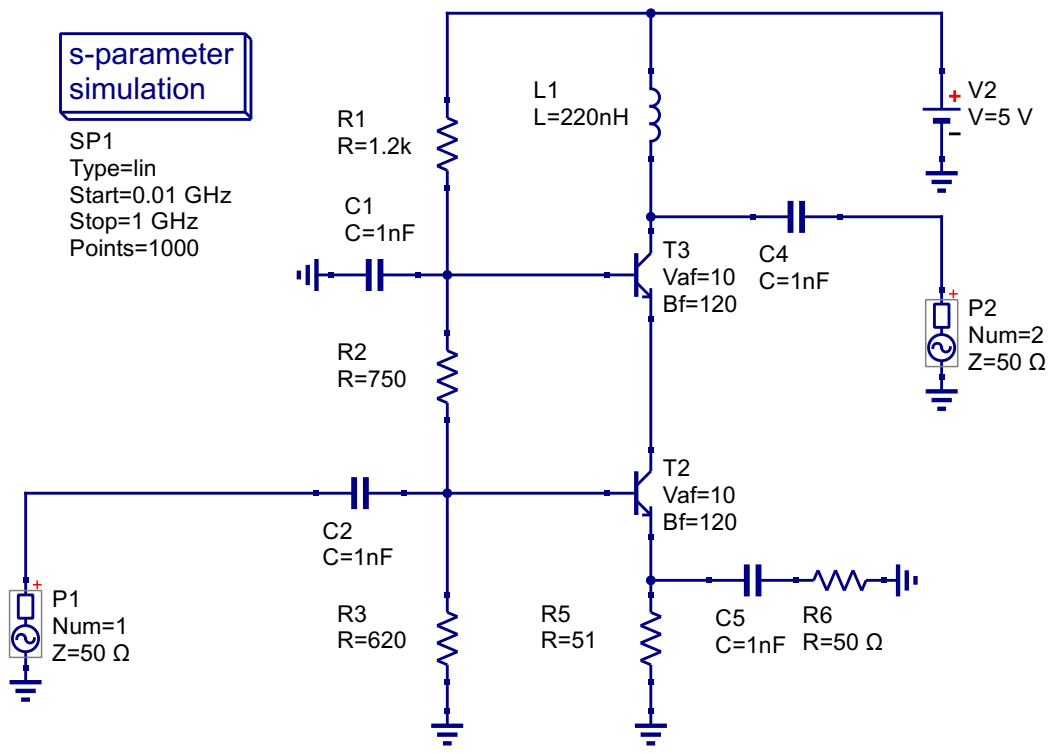
[picture p176: page 1]
