marian1911/CUBESAT_Transponder/Simulaciones/car_cascode_grafico_adaptado.pdf

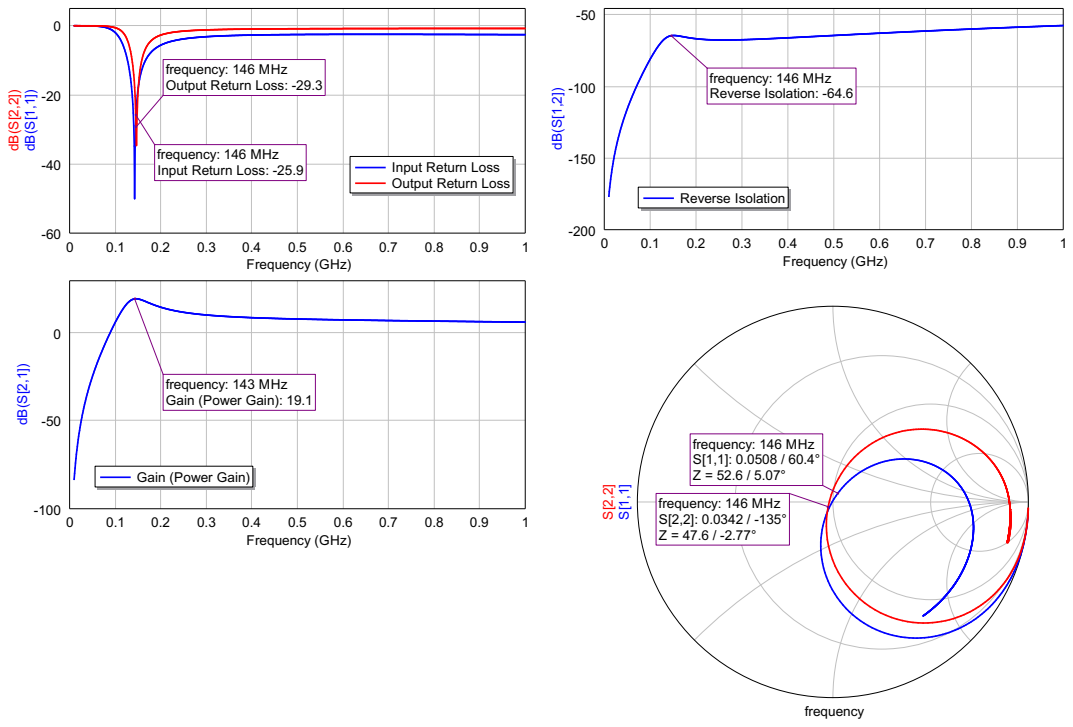
[picture p177: page 1]
Frequency (GHz); Output; Return; Loss; frequency: 146; MHz; frequency: 146 MHz Output; Loss: -29.3; frequency; frequency: 146 MHz S[1,1]: 0.0508 / 60.4° Z = 52.6 / 5.07°; frequency: 146 MHz S[2,2]: 0.0342 / -135° Z = 47.6 / -2.77°

frequency: 146 MHz Reverse Isolation: -64.6

Input Return Loss: -25.9 | Input Return Loss Output Return | Loss

Input Return Loss

ReversReeIsvoelrasteioInsolation

frequency: 143 MHz Gain (Power Gain): 19.1

Gain (PGoawiner(PGoawine)r Gain)
