marian1911/CUBESAT_Transponder/Simulaciones/car_cascode_grafico_desadaptado.pdf

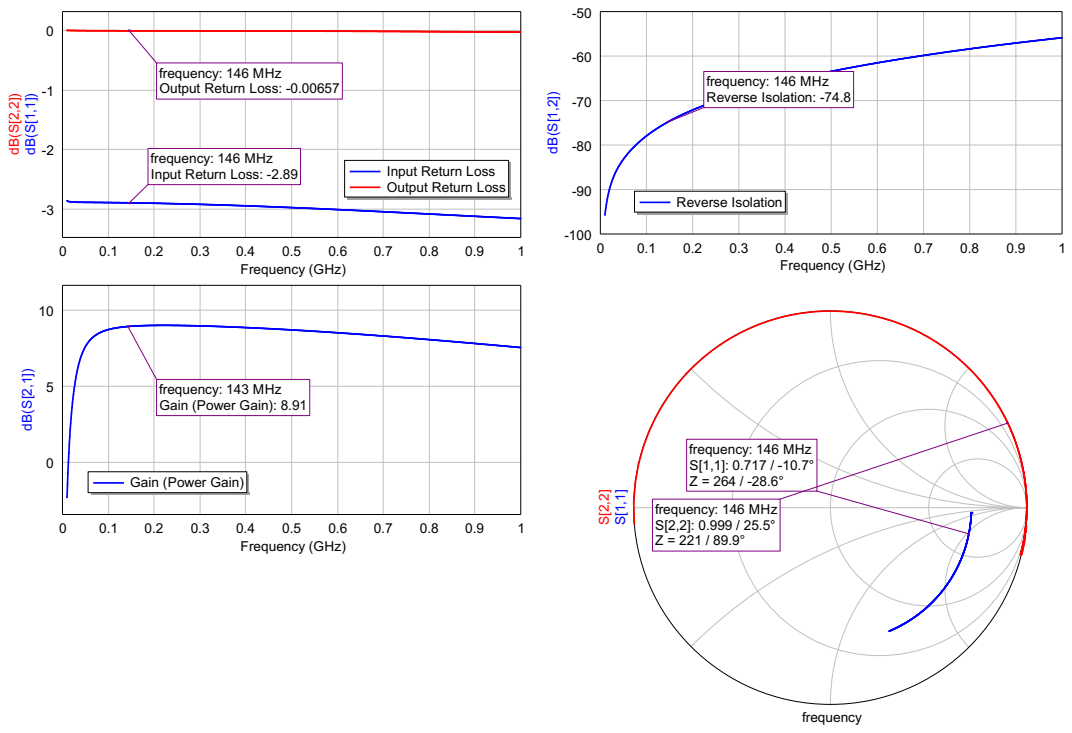
[picture p178: page 1]
Frequency (GHz); Output; Return; Loss; frequency: 146; MHz; frequency: 146 MHz Output; Loss: -0.00657; ReversReeIsvoelrasteioInsolation; frequency; frequency: 146 MHz S[1,1]: 0.717 / -10.7° Z = 264 / -28.6°; frequency: 146 MHz S[2,2]: 0.999 / 25.5° Z = 221 / 89.9°

frequency: 146 MHz Reverse Isolation: -74.8

Input Return Loss: -2.89

Input Return Loss
Output Return Loss

frequency: 143 MHz Gain (Power Gain): 8.91

Gain (PGoawiner(PGoawine)r Gain)
