marian1911/CUBESAT_Transponder/Simulaciones/car_lna_graficos.pdf

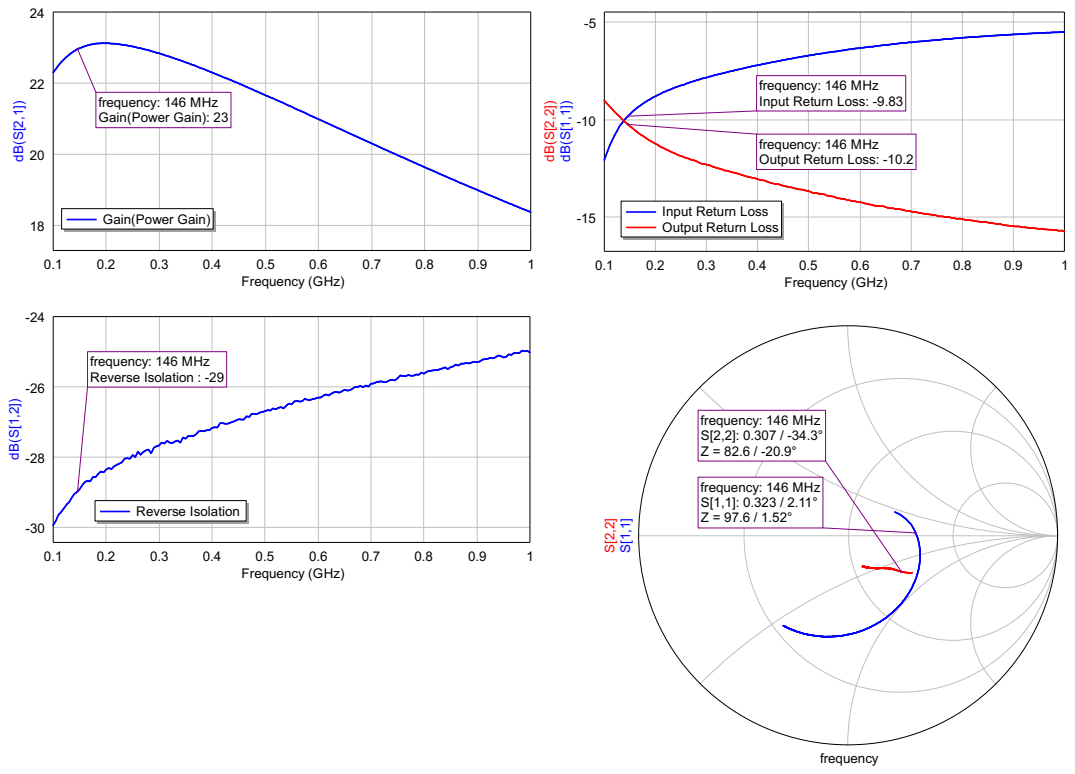
[picture p179: page 1]
Frequency (GHz); ReversReeIsvoelrasteioInsolation; Output; Return Loss; frequency; frequency: 146 MHz S[1,1]: 0.323 / 2.11° Z = 97.6 / 1.52°; frequency: 146 MHz S[2,2]: 0.307 / -34.3° Z = 82.6 / -20.9°

frequency: 146 MHz frequency: 146 MHz Input Return Loss: -9.83 Input Return Loss: -9.83

frequency: 146 MHz Gain(Power Gain): 23

Input | Return Loss | | frequency: 146 MHz Output Return Loss: -10.2

Input Return Loss

Gain(PGowaienr(PGoawine)r Gain)

Output Return | | Loss

frequency: 146 MHz Reverse Isolation : -29
