marian1911/CUBESAT_Transponder/Simulaciones/lna_graficos.pdf

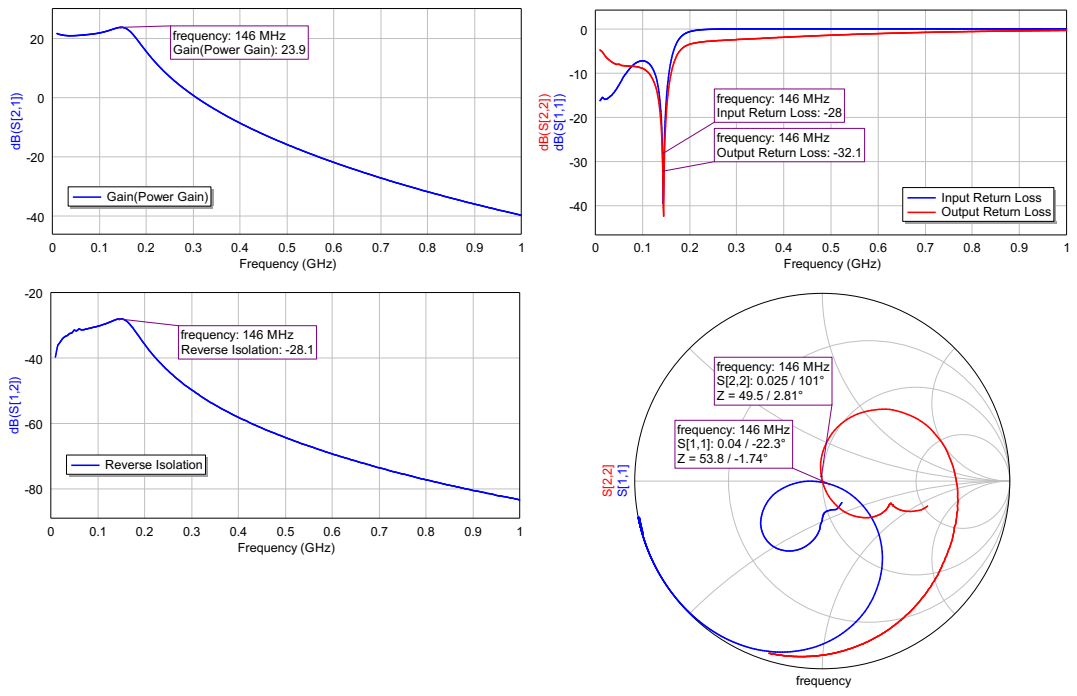
[picture p180: page 1]
Frequency (GHz); ReversReeIsvoelrasteioInsolation; Input; Return Loss; Output Return; Loss; frequency; frequency: 146 MHz S[1,1]: 0.04 / -22.3° Z = 53.8 / -1.74°; frequency: 146 MHz S[2,2]: 0.025 / 101° Z = 49.5 / 2.81°

frequency: 146 MHz Gain(Power Gain): 23.9

frequency: 146 MHz frequency: 146 MHz Input Return Loss: -28 Input Return Loss: -28

frequency: 146 MHz Output Return Loss: -32.1

Gain(PGowaienr(PGoawine)r Gain)

Input Return | Loss
Output Return Loss

frequency: 146 MHz Reverse Isolation: -28.1
