marian1911/CUBESAT_Transponder/KICAD_CUBSAT_V1/PCI-104-Template.kicad_pcb

## KiCad design KICAD_CUBSAT_V1/PCI-104-Template.kicad_pcb (2026-10-17)

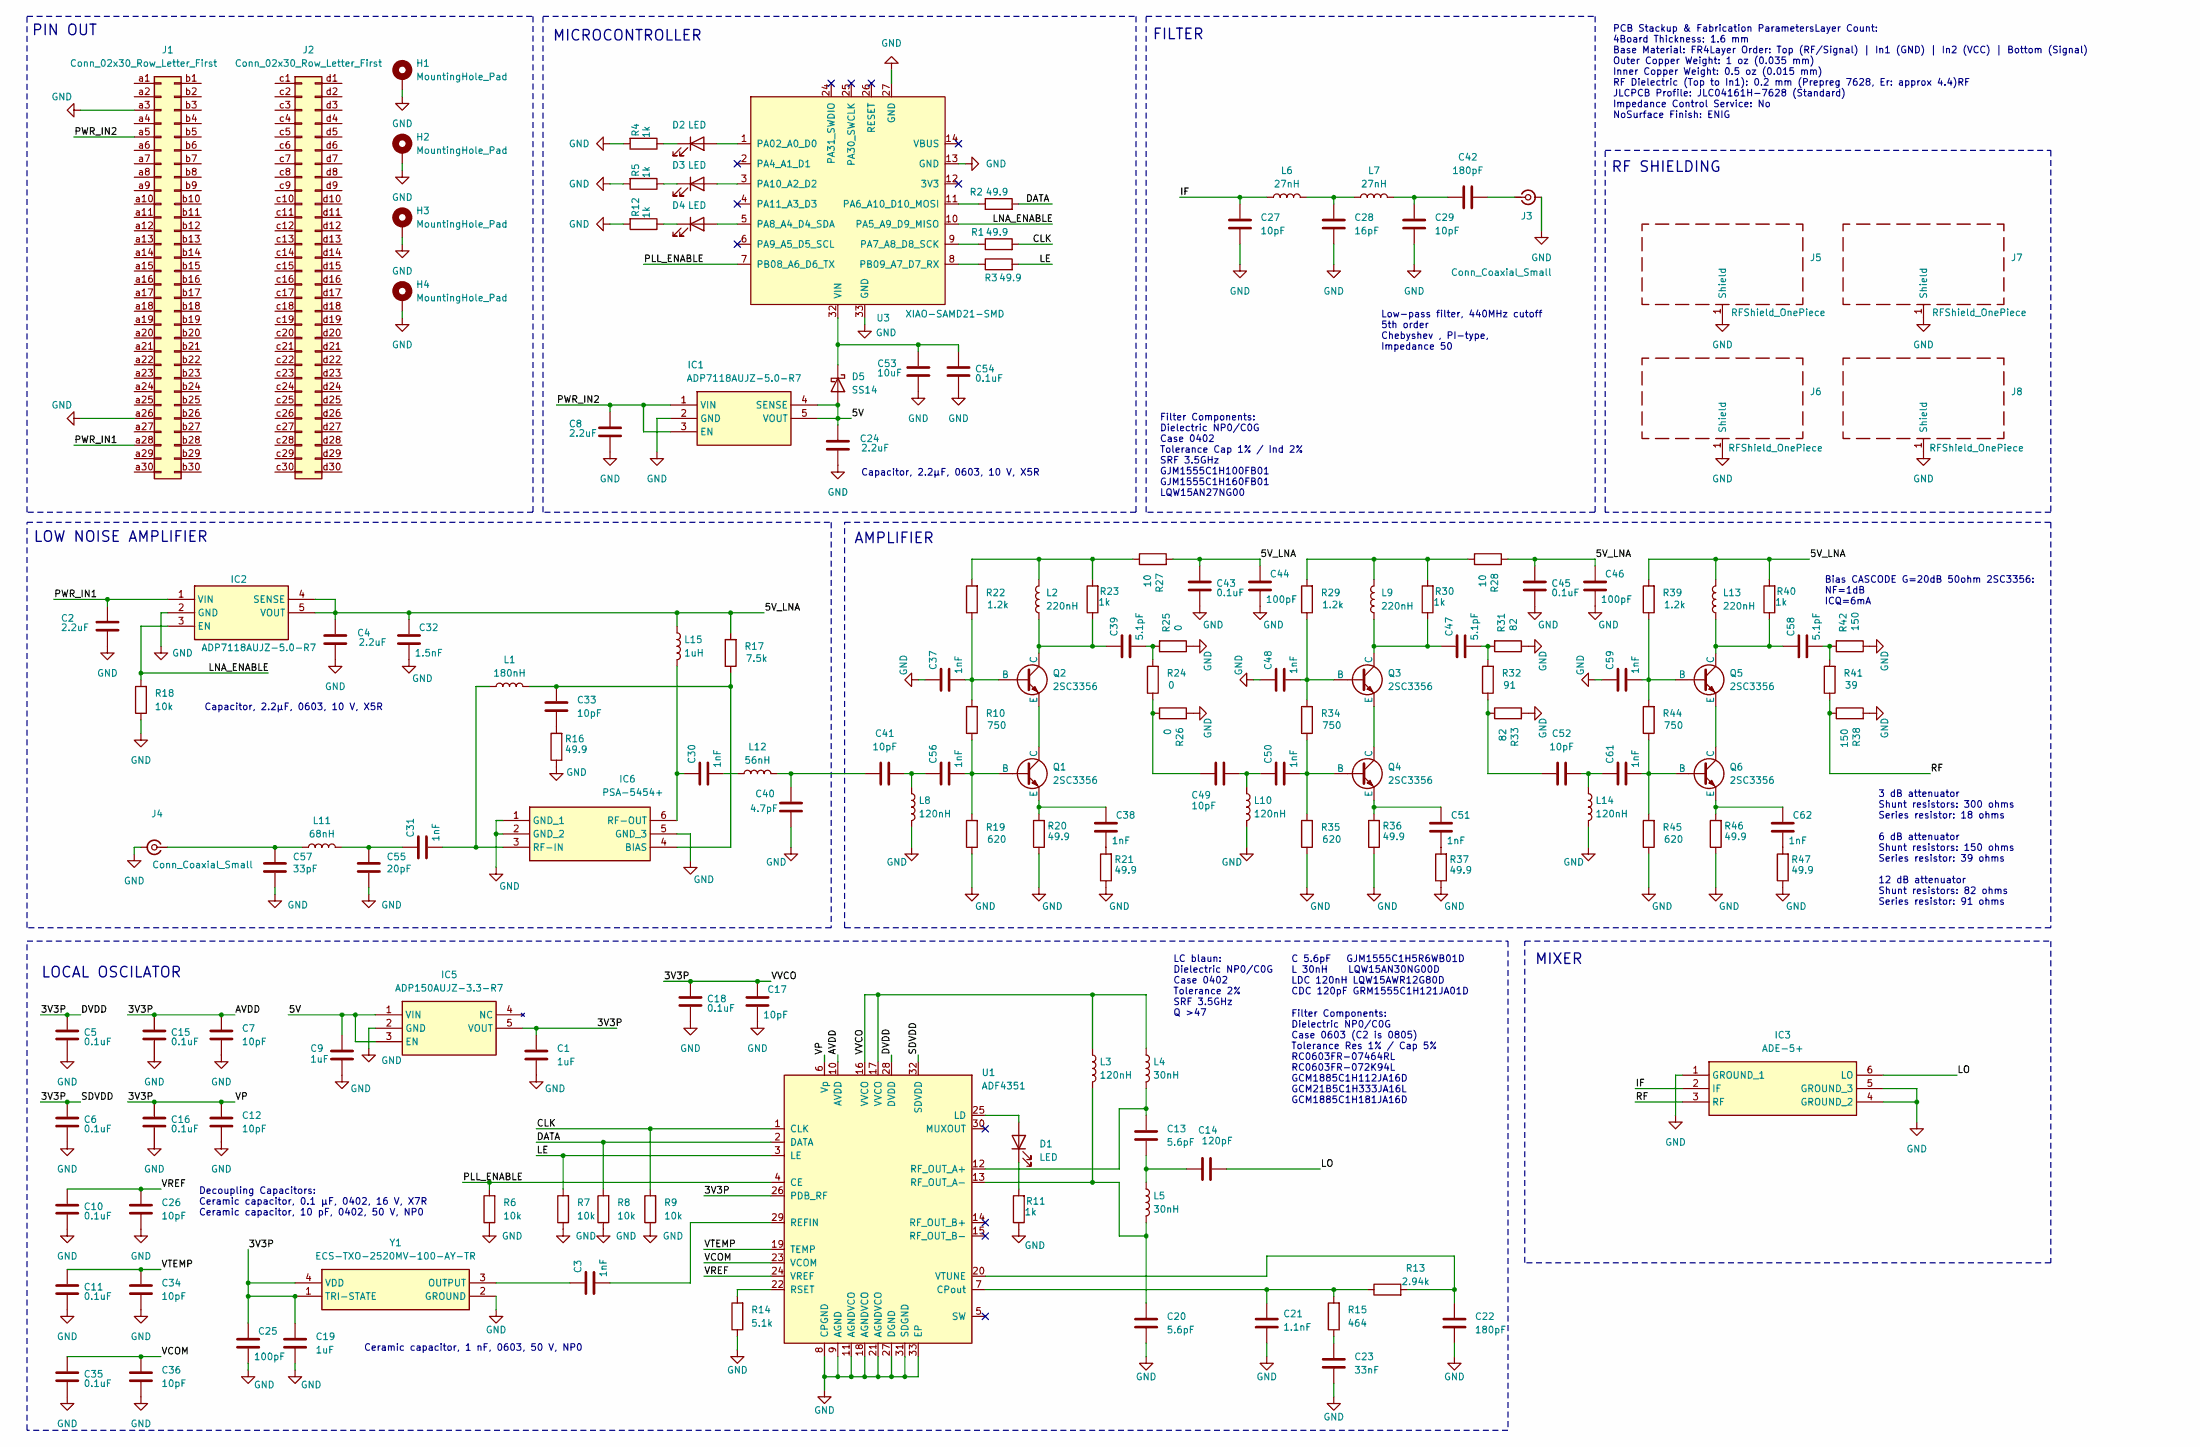
[picture p181: schematic PCI-104-Template.kicad_sch, TRANSPONDER CUBESAT VHF/UHF]

Parts:
C1, C9, C19: 1uF; C_0603_1608Metric; Mouser Part Number 81-GRM39R105K10
C2, C4, C8, C24: 2.2uF; C_0603_1608Metric; Mouser Part Number 81-GRM188R61E225KA2D
C3, C30, C31, C37, C38, C48, C50, C51, C56, C59, C61, C62: 1nF; C_0603_1608Metric; Manufacturer_Part_Number GRM1885C1H102JA01D; Mouser Part Number 81-GRM39C102J50
C5, C6, C10, C11, C15, C16, C18, C35, C43, C45, C54: 0.1uF; C_0402_1005Metric; Manufacturer_Part_Number GRM155R71C104KA88D; Mouser Part Number 81-GRM155R71C104KA88
C7, C12, C26, C27, C29, C33, C34, C36, C41, C49, C52: 10pF; C_0402_1005Metric; Manufacturer_Part_Number GJM1555C1H100FB01D; Mouser Part Number 81-GJM1555C1H100FB01
C13, C20: 5.6pF; C_0402_1005Metric; Manufacturer_Part_Number GJM1555C1H5R6WB01D; Mouser Part Number 81-GJM1555C1H5R6WB1D
C14: 120pF; C_0402_1005Metric; Mouser Part Number 81-GRM1555C1H121JA01
C17: 10pF; C_0402_1005Metric; Manufacturer_Part_Number GRM1555C1H100JA01D; Mouser Part Number 81-GRM1555C1H100JA1D
C21: 1.1nF; C_0603_1608Metric; Mouser Part Number 81-GCM1885C1H112JA6D
C22, C42: 180pF; C_0603_1608Metric; Mouser Part Number 81-GCM1885C1H181J16D
C23: 33nF; C_0805_2012Metric; Mouser Part Number 81-GCM21B5C2A333GE2L
C25, C44, C46: 100pF; C_0402_1005Metric; Manufacturer_Part_Number GCM1555C1H101FA16J; Mouser Part Number 81-GCM1555C1H101FA6J
C28: 16pF; C_0402_1005Metric; Manufacturer_Part_Number GJM1555C1H160FB01J; Mouser Part Number 81-GJM1555C1H160FB1J
C32: 1.5nF; C_0603_1608Metric; Manufacturer_Part_Number GRM1885C1H152JA01J; Mouser Part Number 81-GRM185C1H152JA01J
C39, C47, C58: 5.1pF; C_0402_1005Metric; Manufacturer_Part_Number GJM0225C1C5R1BB01L; Mouser Part Number 81-GJM0225C1C5R1BB1L
C40: 4.7pF; C_0402_1005Metric; Manufacturer_Part_Number GJM0225C1E4R7BB01L; Mouser Part Number 81-GJM0225C1E4R7BB1L
C53: 10uF; C_0805_2012Metric; Mouser Part Number 81-GRT21BR61E106KE3L
C55: 20pF; C_0402_1005Metric; Manufacturer_Part_Number GJM1555C1H200FB01D; Mouser Part Number 81-GJM1555C1H200FB1D
C57: 33pF; C_0402_1005Metric; Manufacturer_Part_Number GCM1555C1H330FA16J; Mouser Part Number 81-GCM1555C1H330FA6J
D1, D2, D3, D4: LED; LED_0603_1608Metric; Manufacturer_Part_Number LTST-C190GKT; Mouser Part Number 859-LTST-C190GKT
D5: SS14; D_SMA; Mouser Part Number 512-SS14
H1, H2, H3, H4: MountingHole_Pad; MountingHole_3.2mm_M3_Pad_TopBottom
IC1, IC2: ADP7118AUJZ-5.0-R7; SOT95P280X100-5N; Mouser Part Number 584-P7118WAUJZ-50-R
IC3: ADE-5+; ADE5; Mouser Part Number 139-ADE-5
IC5: ADP150AUJZ-3.3-R7; SOT95P280X100-5N; Mouser Part Number 584-ADP150AUJZ3.3R7
IC6: PSA-5454+; SOT65P215X100-6N; Mouser Part Number 139-PSA-5454
J1, J2: Conn_02x30_Row_Letter_First; PinSocket_2x30_P2.00mm_Vertical
J3, J4: Conn_Coaxial_Small; SMA_Samtec_SMA-J-P-H-ST-EM1_EdgeMount; Manufacturer_Part_Number SMA-J-P-H-ST-EM1; Mouser Part Number 200-SMAJPHSTEM1
J5, J6, J7, J8: RFShield_OnePiece; Laird_Technologies_BMI-S-102_16.50x16.50mm; Manufacturer_Part_Number BMI-S-102; Mouser Part Number 739-BMI-S-102
L1: 180nH; L_0402_1005Metric; Manufacturer_Part_Number LQW15AWR18J80D; Mouser Part Number 81-LQW15AWR18J80D
L2, L9, L13: 220nH; L_0402_1005Metric; Manufacturer_Part_Number LQW18ANR22G00D; Mouser Part Number 81-LQW18ANR22G00D
L3, L8, L10, L14: 120nH; L_0402_1005Metric; Manufacturer_Part_Number LQW15AWR12G80D; Mouser Part Number 81-LQW15AWR12G80D
L4, L5: 30nH; L_0402_1005Metric; Manufacturer_Part_Number LQW15AN30NG00D; Mouser Part Number 81-LQW15AN30NG00D
L6, L7: 27nH; L_0402_1005Metric; Manufacturer_Part_Number LQW15AN27NG00D; Mouser Part Number 81-LQW15AN27NG00D
L11: 68nH; L_0402_1005Metric; Manufacturer_Part_Number LQW15AN68NG0ZD; Mouser Part Number 81-LQW15AN68NG0ZD
L12: 56nH; L_0402_1005Metric; Manufacturer_Part_Number LQW15AN56NG8ZD; Mouser Part Number 81-LQW15AN56NG8ZD
L15: 1uH; L_0805_2012Metric; Manufacturer_Part_Number LQW21FT1R0M0HL; Mouser Part Number 81-LQW21FT1R0M0HL
Q1, Q2, Q3, Q4, Q5, Q6: 2SC3356; SOT-23
R1, R2, R3, R16, R20, R21, R36, R37, R46, R47: 49.9; R_0603_1608Metric; Manufacturer_Part_Number TNPW060349R9FEEA; Mouser Part Number 71-TNPW060349R9FEEA
R4, R5, R11, R12, R23, R30, R40: 1k; R_0603_1608Metric; Mouser Part Number 71-TNPW06031K00FHEA
R6, R7, R8, R9, R18: 10k; R_0603_1608Metric; Mouser Part Number 71-TNPW060310K0FEEA
R10, R34, R44: 750; R_0603_1608Metric; Manufacturer_Part_Number MCT06030D7500BP500; Mouser Part Number 594-MCT06030D7500BP5
R13: 2.94k; R_0603_1608Metric; Manufacturer_Part_Number RC0603FR-072K94L; Mouser Part Number 603-RC0603FR-072K94L
R14: 5.1k; R_0603_1608Metric; Manufacturer_Part_Number TNPW06035K10FHTA; Mouser Part Number 71-TNPW06035K10FHTA
R15: 464; R_0603_1608Metric; Manufacturer_Part_Number RC0603FR-07464RL; Mouser Part Number 603-RC0603FR-07464RL
R17: 7.5k; R_0603_1608Metric; Manufacturer_Part_Number MCT0603MD7501BP500; Mouser Part Number 594-MCT0603MD7501BP5
R19, R35, R45: 620; R_0603_1608Metric; Manufacturer_Part_Number CRCW0201620RFKED; Mouser Part Number 71-CRCW0201620RFKED
R22, R29, R39: 1.2k; R_0603_1608Metric; Manufacturer_Part_Number TNPW02011K20BEED; Mouser Part Number 71-TNPW02011K20BEED
R24, R25, R26: 0; R_0402_1005Metric; Manufacturer_Part_Number CRCW01000000Z0EL; Mouser Part Number 71-CRCW01000000Z0EL
R27, R28: 10; R_0603_1608Metric; Manufacturer_Part_Number MCT06030C1009FP500; Mouser Part Number 594-MCT06030C1009FP5
R31, R33: 82; R_0402_1005Metric; Manufacturer_Part_Number CRCW040282R0FKTD; Mouser Part Number 71-CRCW040282R0FKTD
R32: 91; R_0402_1005Metric; Manufacturer_Part_Number CRCW040291R0FKED; Mouser Part Number 71-CRCW040291R0FKED
R38, R42: 150; R_0402_1005Metric; Manufacturer_Part_Number CRCW0402150RFKED; Mouser Part Number 71-CRCW0402-150-E3
R41: 39; R_0402_1005Metric; Manufacturer_Part_Number CRCW040239R0FKED; Mouser Part Number 71-CRCW040239R0FKED
U1: ADF4351; LFCSP-32-1EP_5x5mm_P0.5mm_EP3.25x3.25mm; Manufacturer_Part_Number ADF4351BCPZ-RL7; Mouser Part Number 584-ADF4351BCPZ-R7
U3: XIAO-SAMD21-SMD; Manufacturer_Part_Number 102010328; Mouser Part Number 713-102010328
Y1: ECS-TXO-2520MV-100-AY-TR; ECSTXO2520MV120AYTR; Mouser Part Number 520-TXO2520MV100AYTR

Connections:
/3V3P: C1.2, C5.2, C6.2, C7.2, C12.2, C15.2, C16.2, C17.2, C18.2, C19.2, C25.2, IC5.5 (VOUT), L3.1, L4.1, U1.6 (Vp), U1.10 (AVDD), U1.16 (VVCO), U1.17 (VVCO), U1.26 (PDB_RF), U1.28 (DVDD), U1.32 (SDVDD), Y1.1 (TRI-STATE), Y1.4 (VDD)
/5V: C9.2, C24.2, D5.2 (A), IC1.4 (SENSE), IC1.5 (VOUT), IC5.1 (VIN), IC5.3 (EN)
/5V_LNA: C4.2, C32.2, C43.2, C44.2, C45.2, C46.2, IC2.4 (SENSE), IC2.5 (VOUT), L13.2, L15.1, R17.2, R27.2, R28.2, R39.2, R40.2
/CLK: R1.2, R9.2, U1.1 (CLK)
/DATA: R2.2, R8.2, U1.2 (DATA)
/IF: C27.2, IC3.2 (IF), L6.1
/LE: R3.2, R7.2, U1.3 (LE)
/LNA_ENABLE: IC2.3 (EN), R18.2, U3.10 (PA5_A9_D9_MISO)
/LO: C14.2, IC3.6 (LO)
/PLL_ENABLE: R6.2, U1.4 (CE), U3.7 (PB08_A6_D6_TX)
/PWR_IN1: C2.2, IC2.1 (VIN), J1.a28
/PWR_IN2: C8.2, IC1.1 (VIN), IC1.3 (EN), J1.a5
/RF: IC3.3 (RF), R38.1, R41.1
/VCOM: C35.2, C36.2, U1.23 (VCOM)
/VREF: C10.2, C26.2, U1.24 (VREF)
/VTEMP: C11.2, C34.2, U1.19 (TEMP)
GND: C1.1, C2.1, C4.1, C5.1, C6.1, C7.1, C8.1, C9.1, C10.1, C11.1, C12.1, C15.1, C16.1, C17.1, C18.1, C19.1, C20.1, C21.1, C22.1, C23.1, C24.1, C25.1, C26.1, C27.1, C28.1, C29.1, C32.1, C34.1, C35.1, C36.1, C37.2, C40.1, C43.1, C44.1, C45.1, C46.1, C48.2, C53.1, C54.1, C55.1, C57.1, C59.2, H1.1, H2.1, H3.1, H4.1, IC1.2 (GND), IC2.2 (GND), IC3.1 (GROUND_1), IC3.4 (GROUND_2), IC3.5 (GROUND_3), IC5.2 (GND), IC6.1 (GND_1), IC6.2 (GND_2), IC6.5 (GND_3), J1.a3, J1.a26, J3.2 (Ext), J4.2 (Ext), J5.1 (Shield), J6.1 (Shield), J7.1 (Shield), J8.1 (Shield), L8.2, L10.2, L14.2, R4.2, R5.2, R6.1, R7.1, R8.1, R9.1, R11.1, R12.2, R14.1, R16.1, R18.1, R19.1, R20.1, R21.1, R25.1, R26.2, R31.1, R33.2, R35.1, R36.1, R37.1, R38.2, R42.1, R45.1, R46.1, R47.1, U1.8 (CPGND), U1.9 (AGND), U1.11 (AGNDVCO), U1.18 (AGNDVCO), U1.21 (AGNDVCO), U1.27 (DGND), U1.31 (SDGND), U1.33 (EP), U3.13 (GND), U3.27 (GND), U3.33 (GND), Y1.2 (GROUND)
unnamed: C13.1, C14.1, L5.1
unnamed: C23.2, R15.1
unnamed: C28.2, L6.2, L7.1
unnamed: C29.2, C42.2, L7.2
unnamed: C30.1, L12.1
unnamed: C31.2, C55.2, L11.2
unnamed: C33.1, R16.2
unnamed: C38.1, R21.2
unnamed: C39.1, R24.2, R25.2
unnamed: C40.2, C41.2, L12.2
unnamed: C41.1, C56.2, L8.1
unnamed: C47.1, R31.2, R32.2
unnamed: C49.1, C50.2, L10.1
unnamed: C49.2, R24.1, R26.1
unnamed: C51.1, R37.2
unnamed: C52.1, C61.2, L14.1
unnamed: C52.2, R32.1, R33.1
unnamed: C58.1, R41.2, R42.2
unnamed: C62.1, R47.2
unnamed: D1.2 (A), U1.25 (LD)
unnamed: D1.1 (K), R11.2
unnamed: D2.2 (A), U3.1 (PA02_A0_D0)
unnamed: D2.1 (K), R4.1
unnamed: D3.2 (A), U3.3 (PA10_A2_D2)
unnamed: D3.1 (K), R5.1
unnamed: D4.2 (A), U3.5 (PA8_A4_D4_SDA)
unnamed: D4.1 (K), R12.1
unnamed: C53.2, C54.2, D5.1 (K), U3.32 (VIN)
unnamed: C33.2, IC6.4 (BIAS), L1.2, R17.1
unnamed: C31.1, IC6.3 (RF-IN), L1.1
unnamed: C30.2, IC6.6 (RF-OUT), L15.2
unnamed: C42.1, J3.1 (In)
unnamed: C57.2, J4.1 (In), L11.1
unnamed: L2.2, R22.2, R23.2, R27.1
unnamed: L9.2, R28.1, R29.2, R30.2
unnamed: C56.1, Q1.2 (B), R10.1, R19.2
unnamed: Q1.1 (C), Q2.3 (E)
unnamed: C38.2, Q1.3 (E), R20.2
unnamed: C37.1, Q2.2 (B), R10.2, R22.1
unnamed: C39.2, L2.1, Q2.1 (C), R23.1
unnamed: C48.1, Q3.2 (B), R29.1, R34.2
unnamed: C47.2, L9.1, Q3.1 (C), R30.1
unnamed: Q3.3 (E), Q4.1 (C)
unnamed: C50.1, Q4.2 (B), R34.1, R35.2
unnamed: C51.2, Q4.3 (E), R36.2
unnamed: C59.1, Q5.2 (B), R39.1, R44.2
unnamed: C58.2, L13.1, Q5.1 (C), R40.1
unnamed: Q5.3 (E), Q6.1 (C)
unnamed: C61.1, Q6.2 (B), R44.1, R45.2
unnamed: C62.2, Q6.3 (E), R46.2
unnamed: C21.2, R13.1, R15.2, U1.7 (CPout)
unnamed: C3.1, U1.29 (REFIN)
unnamed: C13.2, L4.2, U1.12 (RF_OUT_A+)
unnamed: C20.2, L3.2, L5.2, U1.13 (RF_OUT_A-)
unnamed: R14.2, U1.22 (RSET)
unnamed: C22.2, R13.2, U1.20 (VTUNE)
unnamed: R2.1, U3.11 (PA6_A10_D10_MOSI)
unnamed: R1.1, U3.9 (PA7_A8_D8_SCK)
unnamed: R3.1, U3.8 (PB09_A7_D7_RX)
unnamed: C3.2, Y1.3 (OUTPUT)

Notes on the sheet:
Ceramic capacitor, 1 nF, 0603, 50 V, NP0
Filter Components: Dielectric NP0/C0G Case 0402 Tolerance Cap 1% / Ind 2% SRF 3.5GHz GJM1555C1H100FB01 GJM1555C1H160FB01 LQW15AN27NG00
MICROCONTROLLER
Decoupling Capacitors: Ceramic capacitor, 0.1 µF, 0402, 16 V, X7R Ceramic capacitor, 10 pF, 0402, 50 V, NP0
AMPLIFIER
C 5.6pF GJM1555C1H5R6WB01D L 30nH LQW15AN30NG00D LDC 120nH LQW15AWR12G80D CDC 120pF GRM1555C1H121JA01D
MIXER
LC blaun: Dielectric NP0/C0G Case 0402 Tolerance 2% SRF 3.5GHz Q >47
Capacitor, 2.2µF, 0603, 10 V, X5R
FILTER
PCB Stackup & Fabrication ParametersLayer Count: 4Board Thickness: 1.6 mm Base Material: FR4Layer Order: Top (RF/Signal) | In1 (GND) | In2 (VCC) | Bottom (Signal) Outer Copper Weight: 1 oz (0.035 mm) Inner Copper Weight: 0.5 oz (0.015 mm) RF Dielectric (Top to In1): 0.2 mm (Prepreg 7628, Er: approx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
Low-pass filter, 440MHz cutoff 5th order Chebyshev , PI-type, Impedance 50
LOW NOISE AMPLIFIER
RF SHIELDING
LOCAL OSCILATOR
Bias CASCODE G=20dB 50ohm 2SC3356: NF=1dB ICQ=6mA
PIN OUT
3 dB attenuator Shunt resistors: 300 ohms Series resistor: 18 ohms 6 dB attenuator Shunt resistors: 150 ohms Series resistor: 39 ohms 12 dB attenuator Shunt resistors: 82 ohms Series resistor: 91 ohms
Filter Components: Dielectric NP0/C0G Case 0603 (C2 is 0805) Tolerance Res 1% / Cap 5% RC0603FR-07464RL RC0603FR-072K94L GCM1885C1H112JA16D GCM21B5C1H333JA16L GCM1885C1H181JA16D

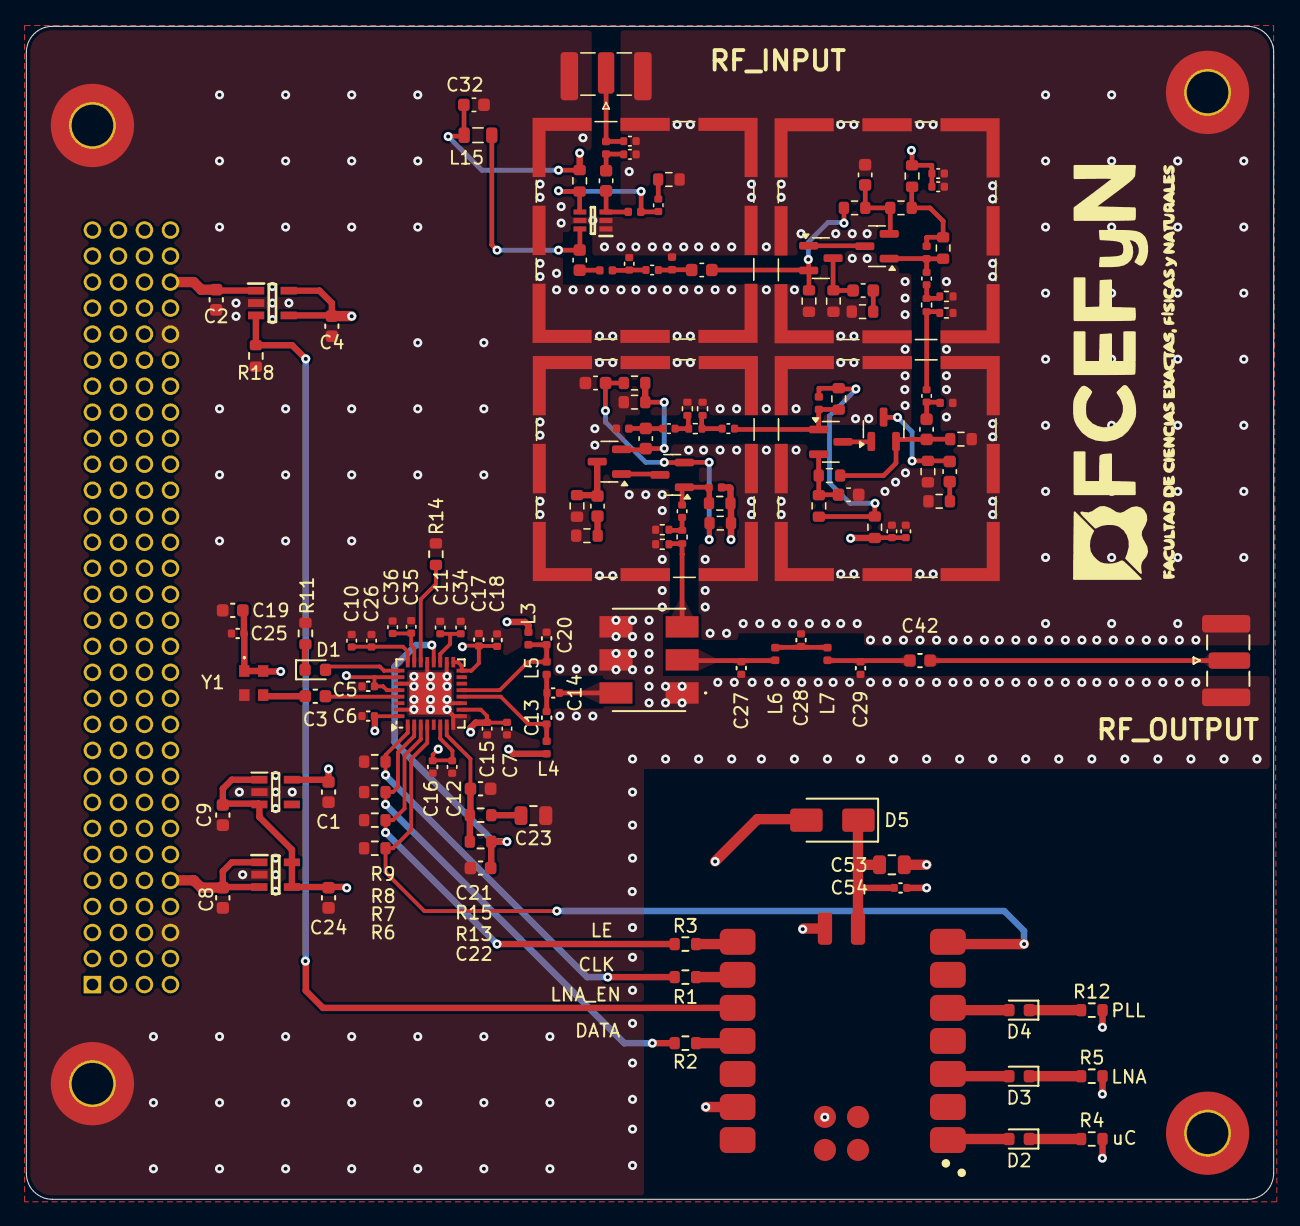
[picture p182: board PCI-104-Template.kicad_pcb from above]

Board: 4 copper layers, 95.9 x 90.2 mm, 153 parts (0 on the bottom side), 77 nets.
