marian1911/CUBESAT_Transponder/(commit log)

2026-08-06 copia de respaldo privada tesis
2026-08-22 update micro, diseño de la placa, falta terminar
2026-09-29 update bom
